Pranav221294/New_AFT_my_code/AFT_SENSOR/Design_DevelopmentDocs/EEPROM_data_on_2_Probe_Pic.png

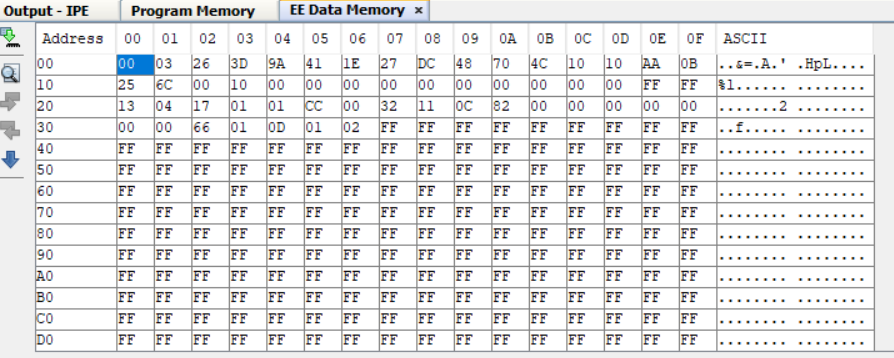
AFT_SENSOR/Design_DevelopmentDocs/EEPROM_data_on_2_Probe_Pic.png
