Pranav221294/New_AFT_my_code/AFT_SENSOR/Code/CodeWithBootLoader/Exe to generate bin/ReadMe.txt

after changing application .mot file to .bin file, rename the .bin file as Ultra24V.bin
then upload through app.
