Pranav221294/New_AFT_my_code/AFT_SENSOR/Requirements/AFT_Sensor_Technical_document_V0.0.pdf

# INDICATION INSTRUMENTS LIMITED

## Design Specification for AFT Sensor

This document is the property of Indication Instruments Limited Plot 19, Sector 6, Faridabad. This document or any information it contains may not be copied, reproduced, disclosed to others or used without the written permission from Veethree. This document must be returned upon request.

### P a g e 1 | 31

# Design Specification for

# AFT Sensor

## Approvals

## Customer: _________________________________________________

Name: | _____________ | ________________________________
Title: | _______ | __ | __________________________________
Date: | _________________ | __________

## Veethree: _________________________________________________

Name: | _____________ | ________________________________
Title: | _______ | __ | __________________________________

## Date:

# Facility: Indication Instruments Limited Plot No.19, Sector-6, Faridabad Haryana, India Rev# 0.0 Last update: May 31, 2022

### P a g e 2 | 31

# TABLE OF CONTENTS

### P a g e 3 | 31

# TABLES & FIGURES

No table of figures entries found.

### P a g e 4 | 31

# REVISION HISTORY

Rev | Date | Author | Reviewed By | Description
0.0 | 31st May 2022 | Ruchi Bhargava | Nikita/Anuj Garg | Initial version

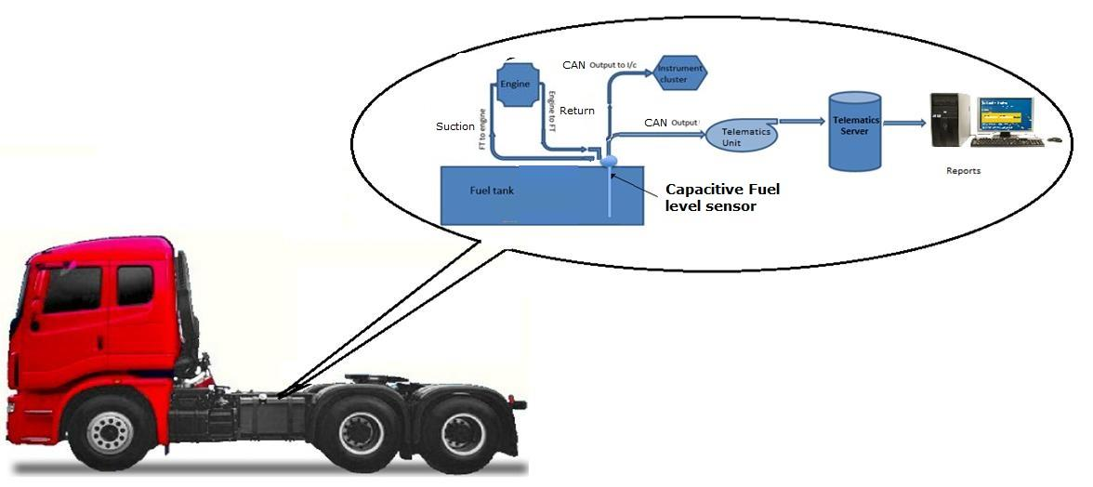
[picture p5: figure]

### P a g e 5 | 31

## 1.Introduction

## This document details the idea of Fuel Anti-Theft Sensor (AFT) or capacitive sensor. The proposed method of measurement of fuel level is based on the variation in the capacitance

based on the difference in dielectric properties between fuel and free air without any moving parts. The details of implementation are outside the scope of this document.

## 2. Acronyms, Abbreviations and Definitions

AFT | Anti Fuel Theft Sensor

## 3. References

Reference | Document

## Emails exchanged with TML

## 4. System Architecture

## MCU Platform : Renesas

## Memory :

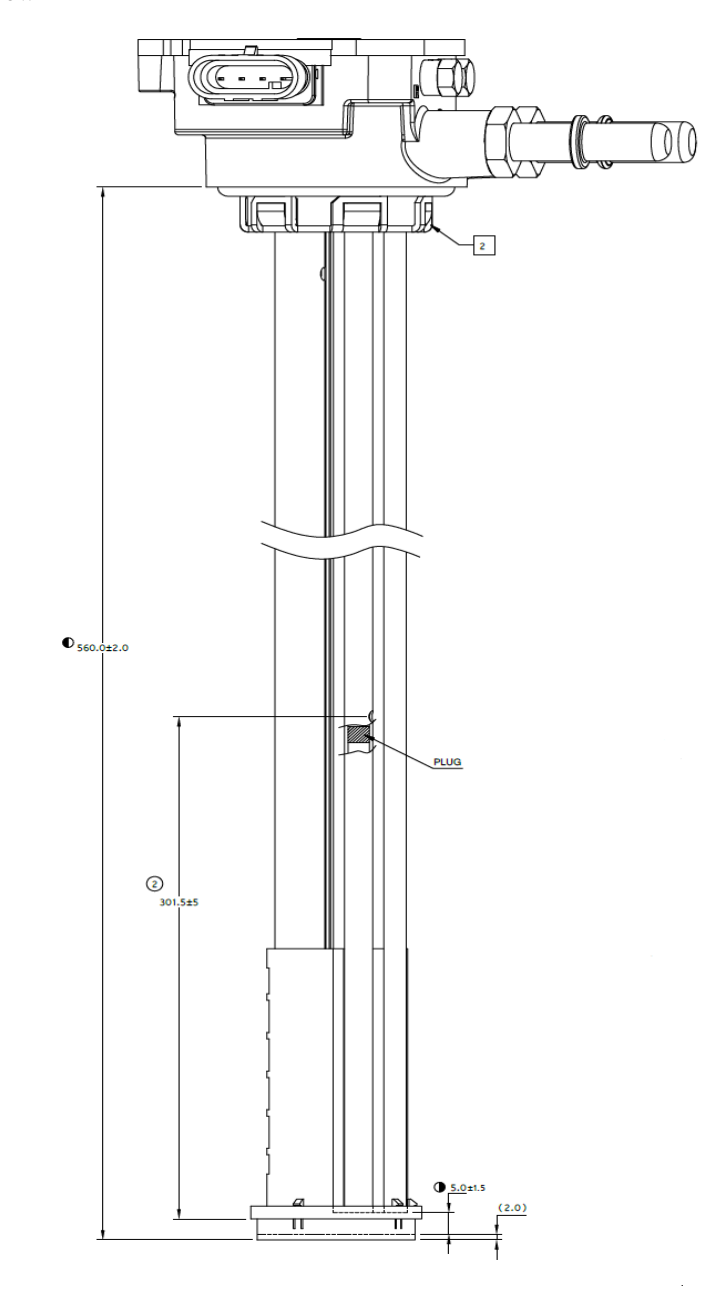
[picture p6: figure]

### P a g e 6 | 31

## 5. Fitment Requirement

Variant 1 : 365 Ltr.

## View From Arrow X

### P a g e 7 | 31

## View From Arrow Y

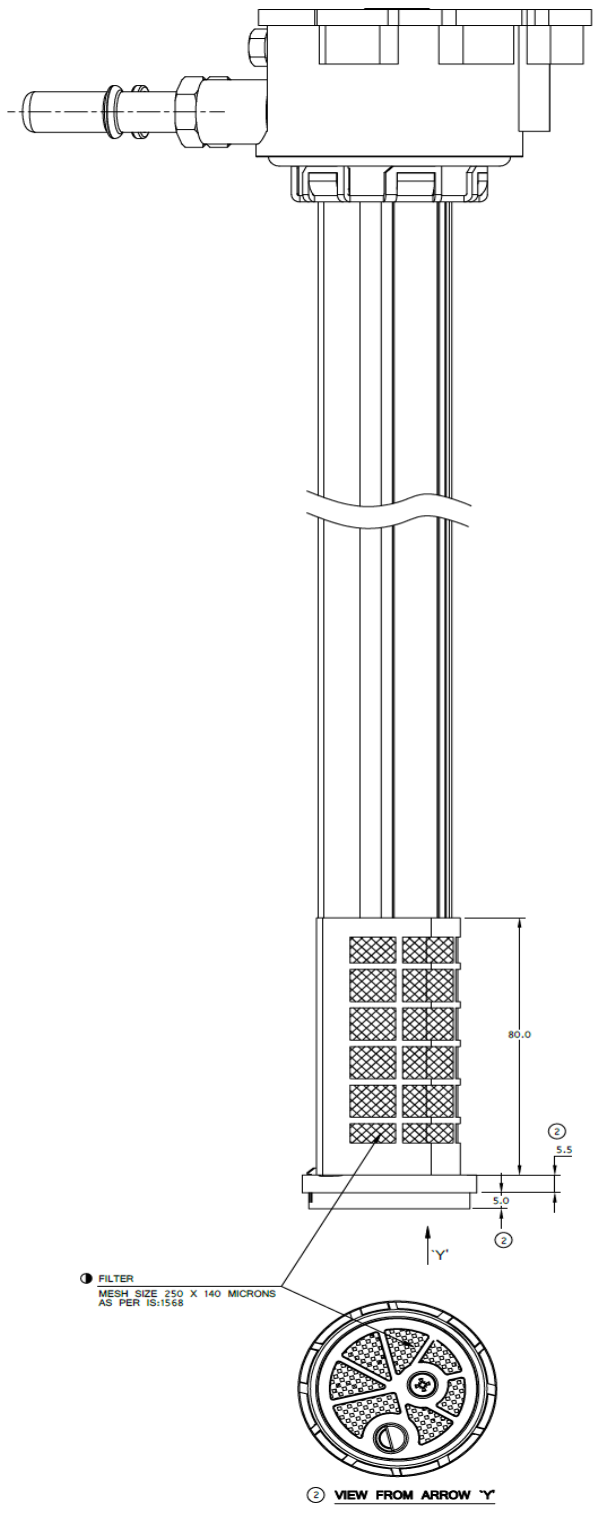
[picture p7: figure]

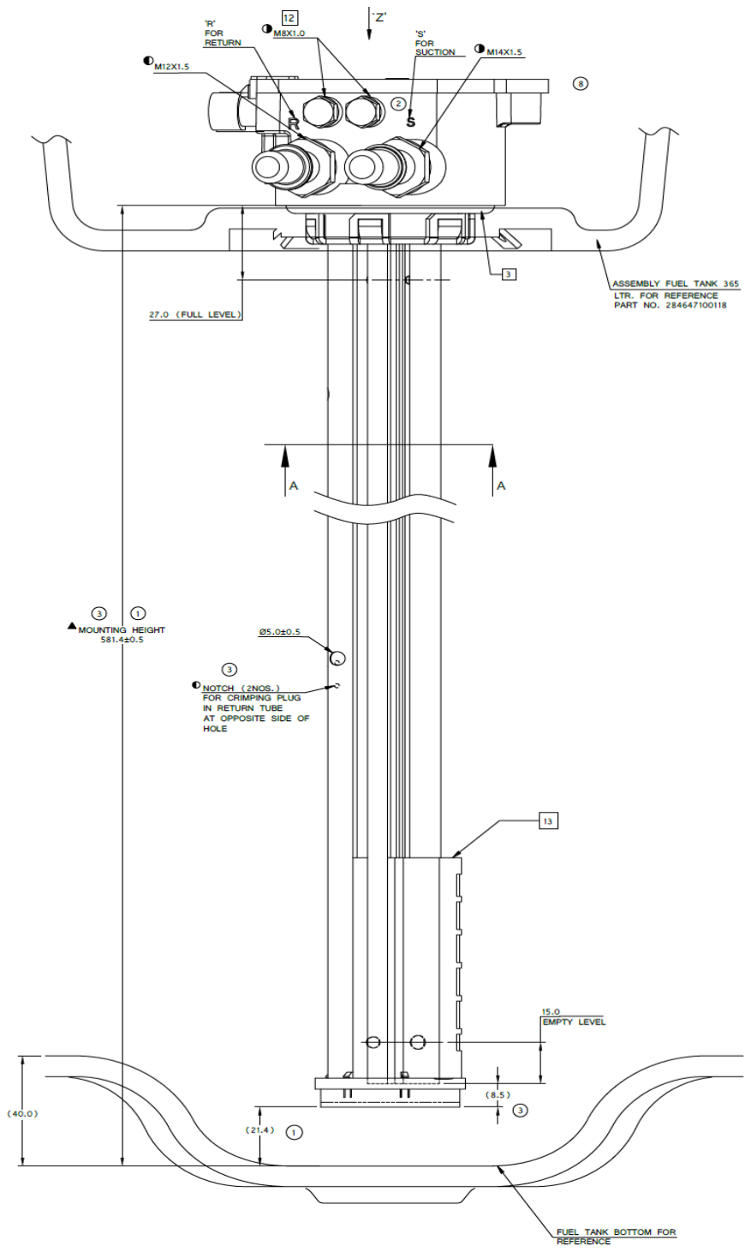
[picture p8: figure]

### P a g e 8 | 31

## View From Arrow Z

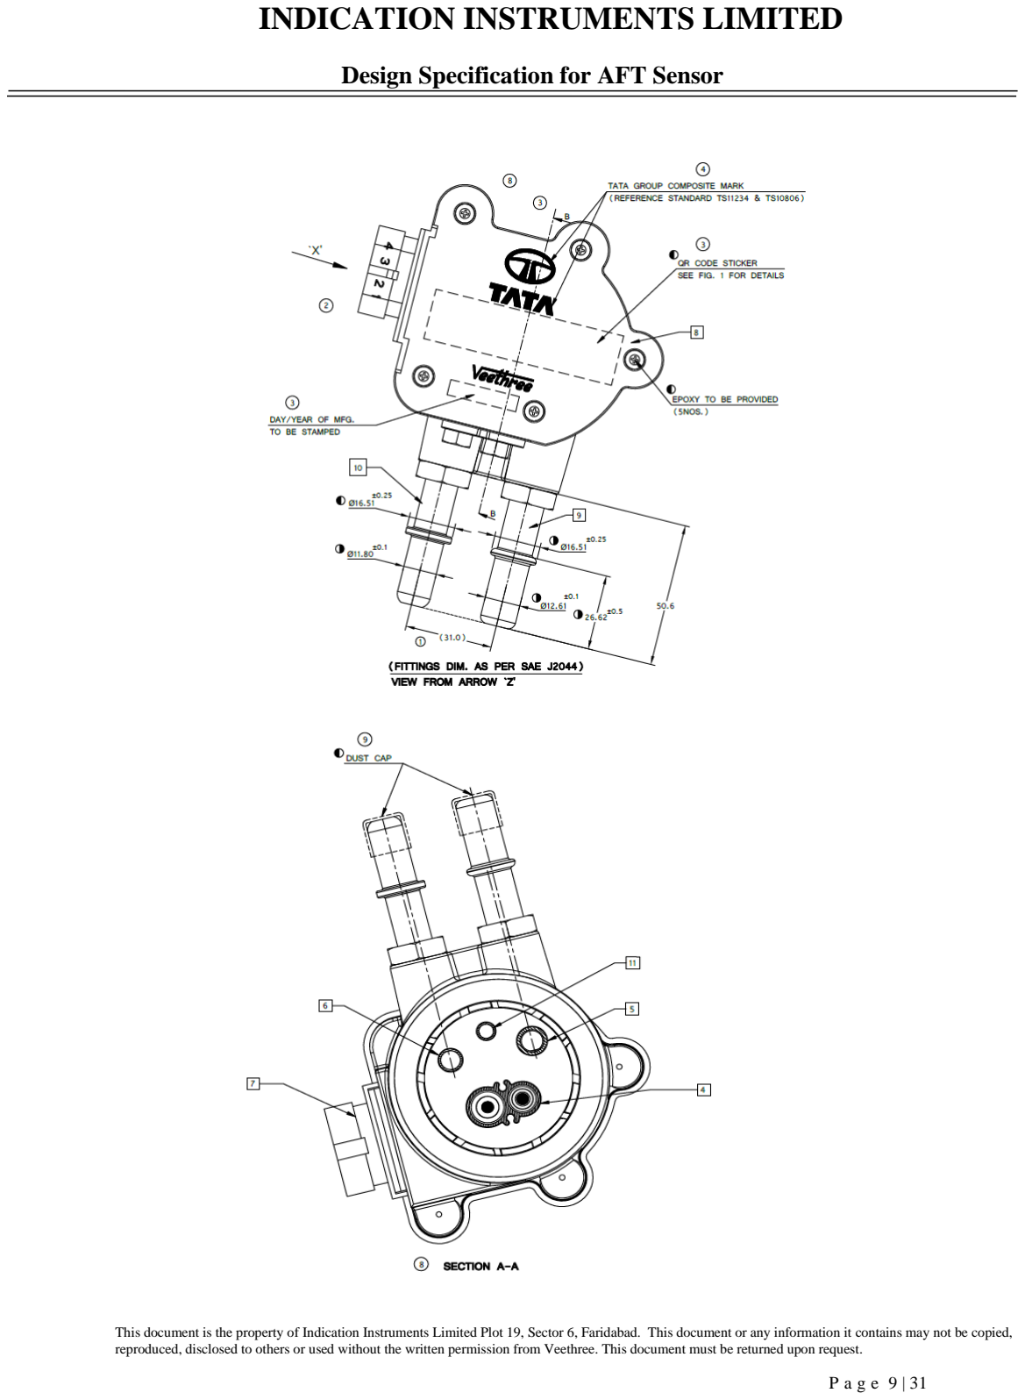
[picture p9: page 9]

### P a g e 9 | 31

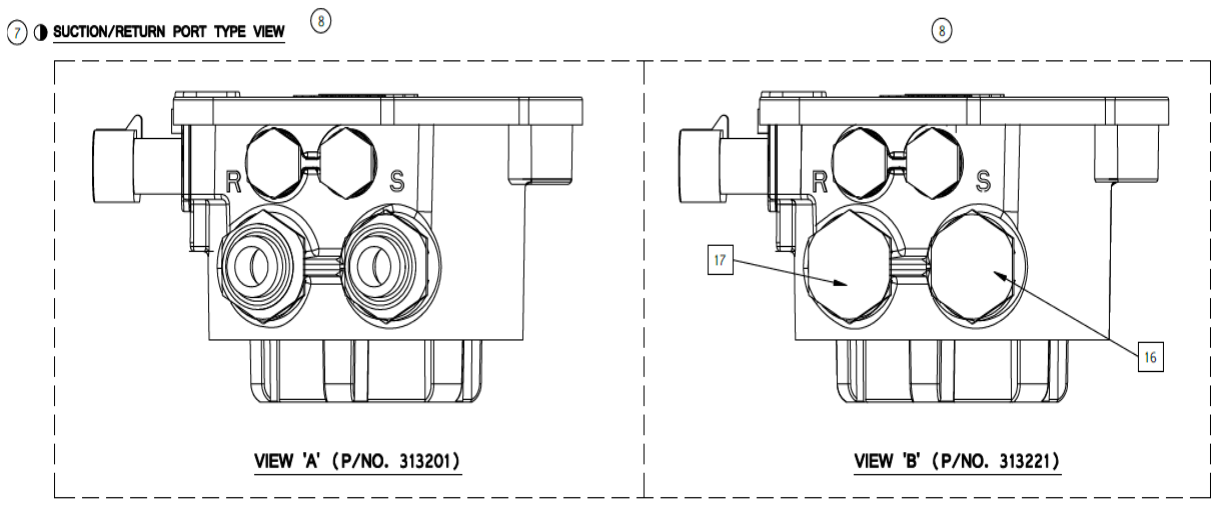
[picture p10: figure]

### P a g e 10 | 31

## Suction/Return Port Type View

Variant 2 : 300 Ltr. & 280 Ltr.

## View From Arrow X

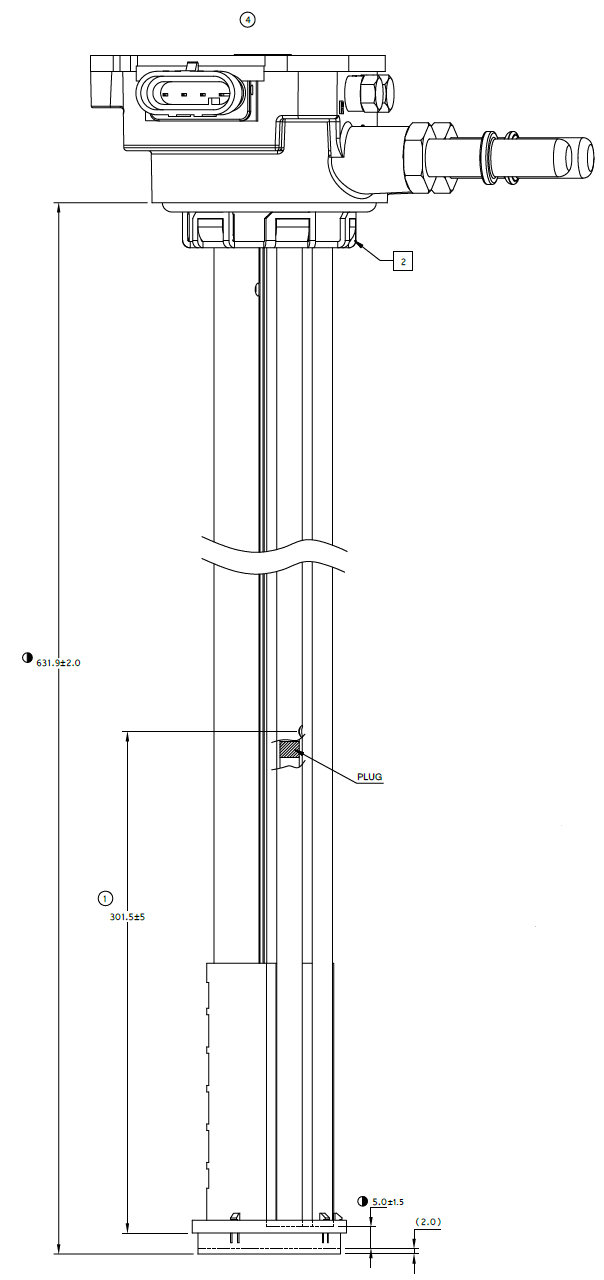
[picture p11: figure]

### P a g e 11 | 31

### P a g e 12 | 31

## View From Arrow Y

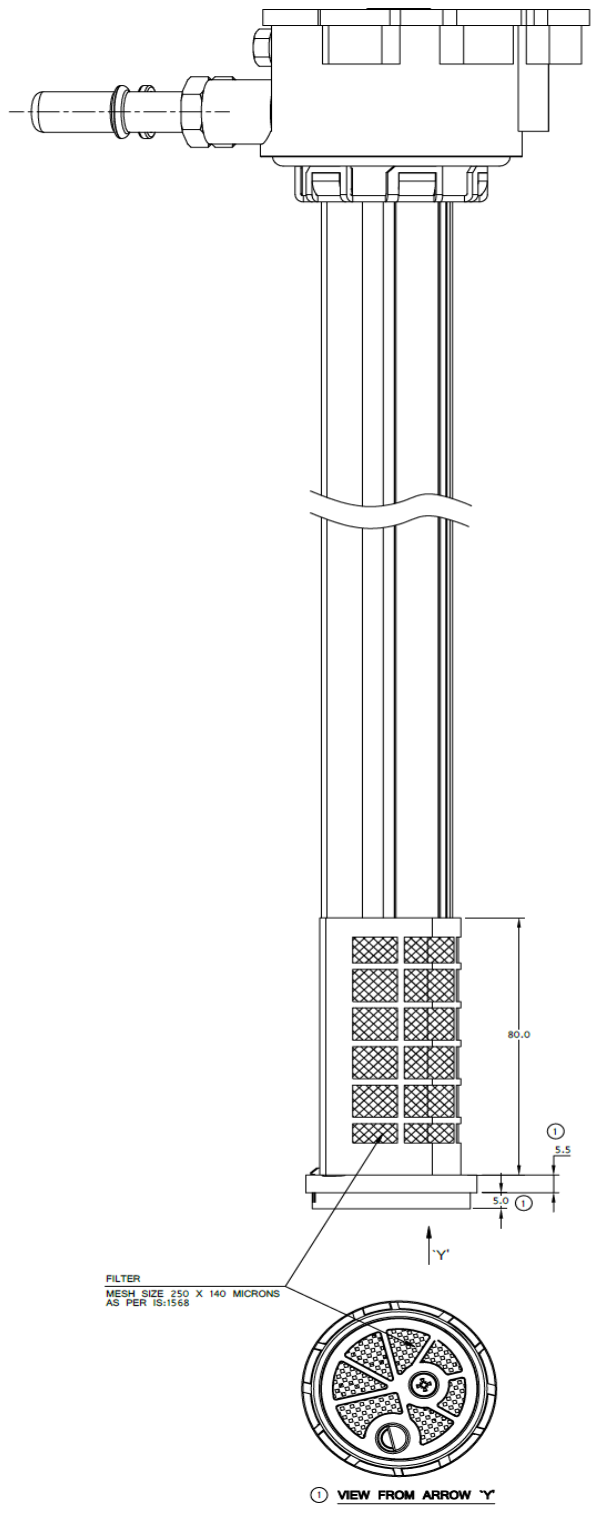
[picture p12: figure]

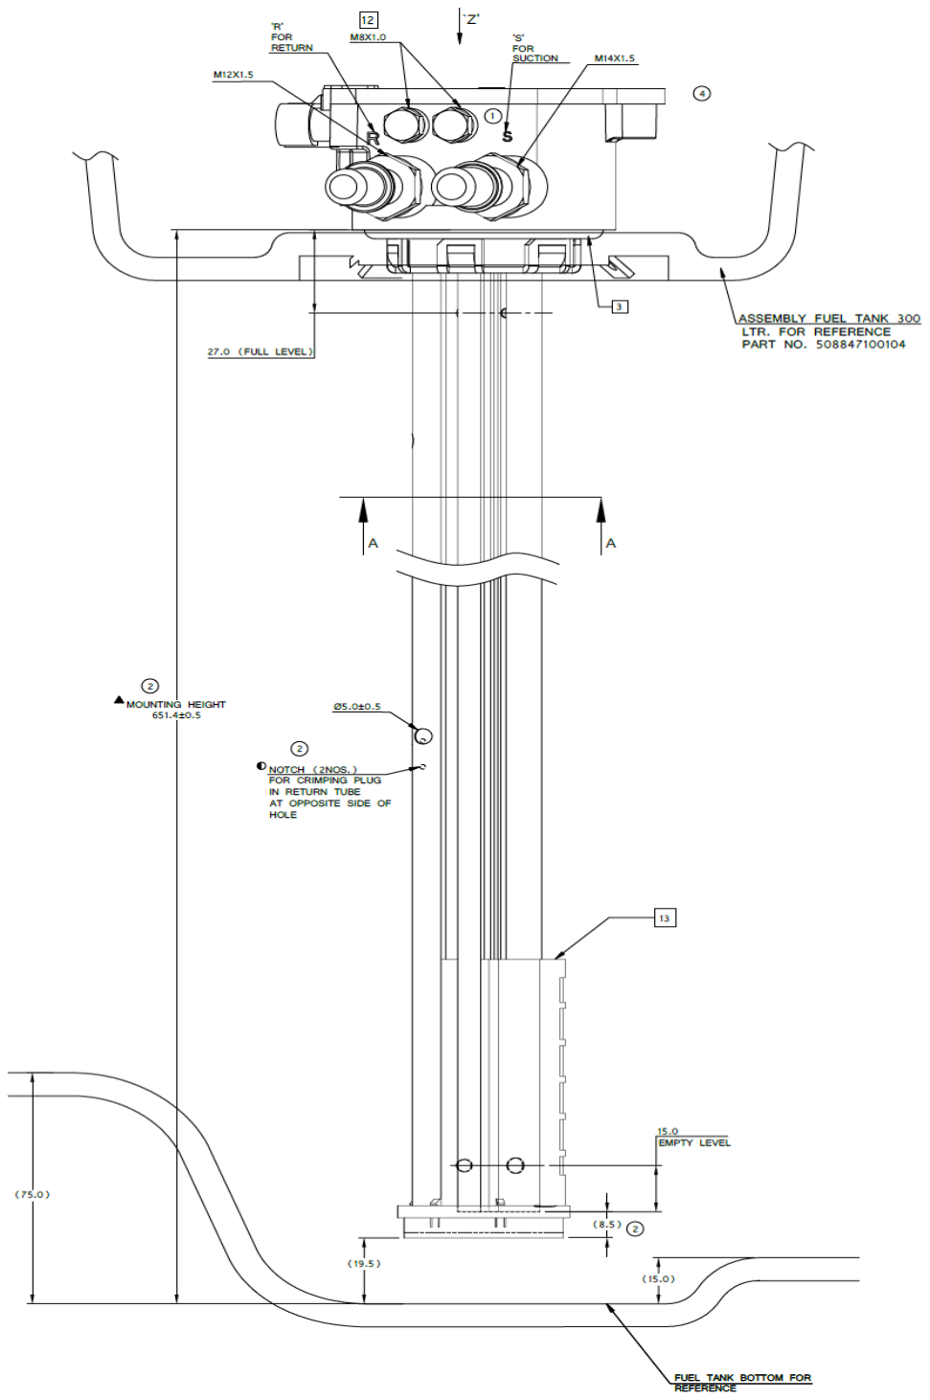
[picture p13: figure]

### P a g e 13 | 31

## View From Arrow Z

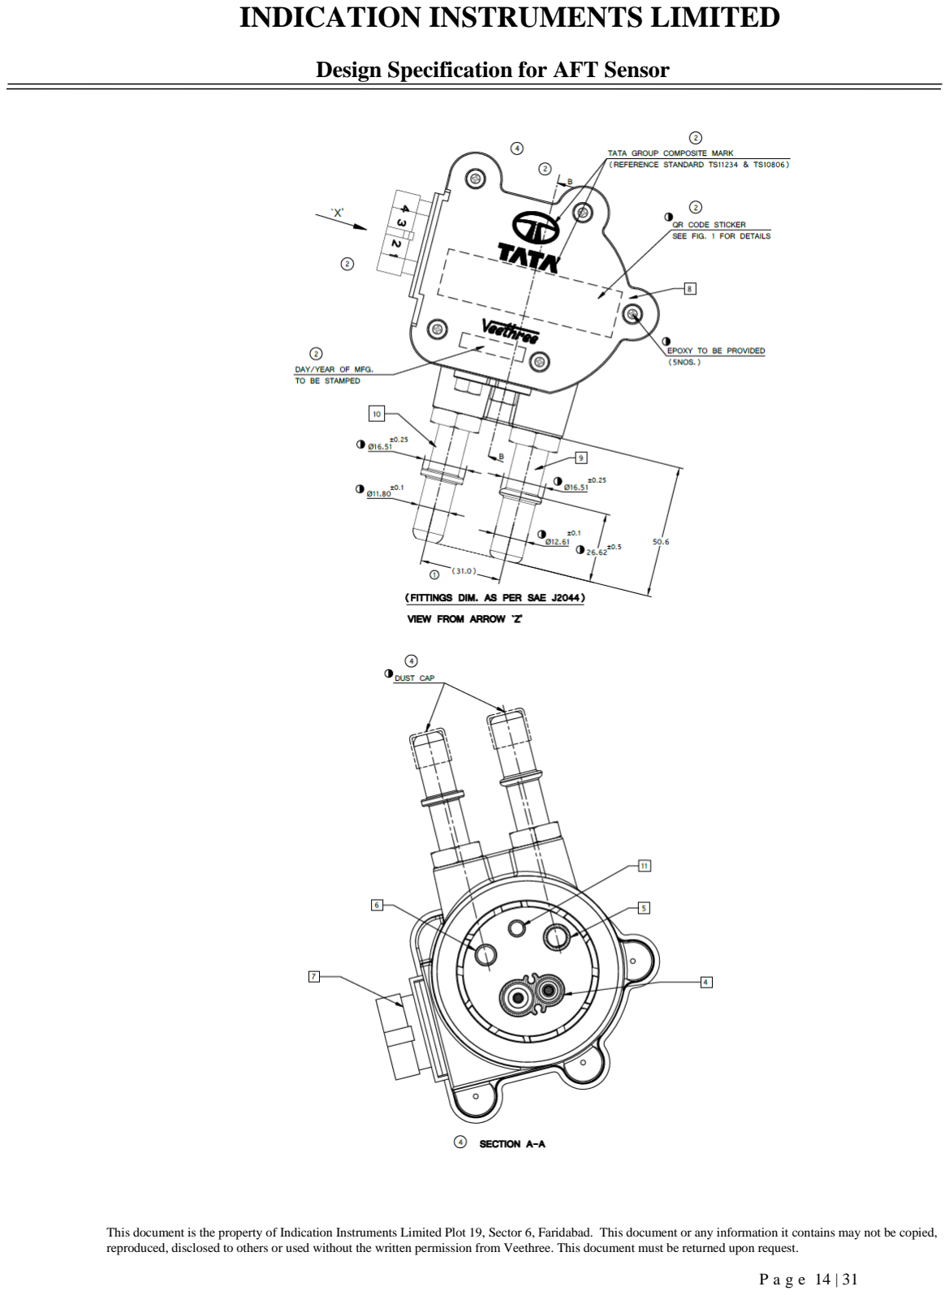
[picture p14: page 14]

### P a g e 14 | 31

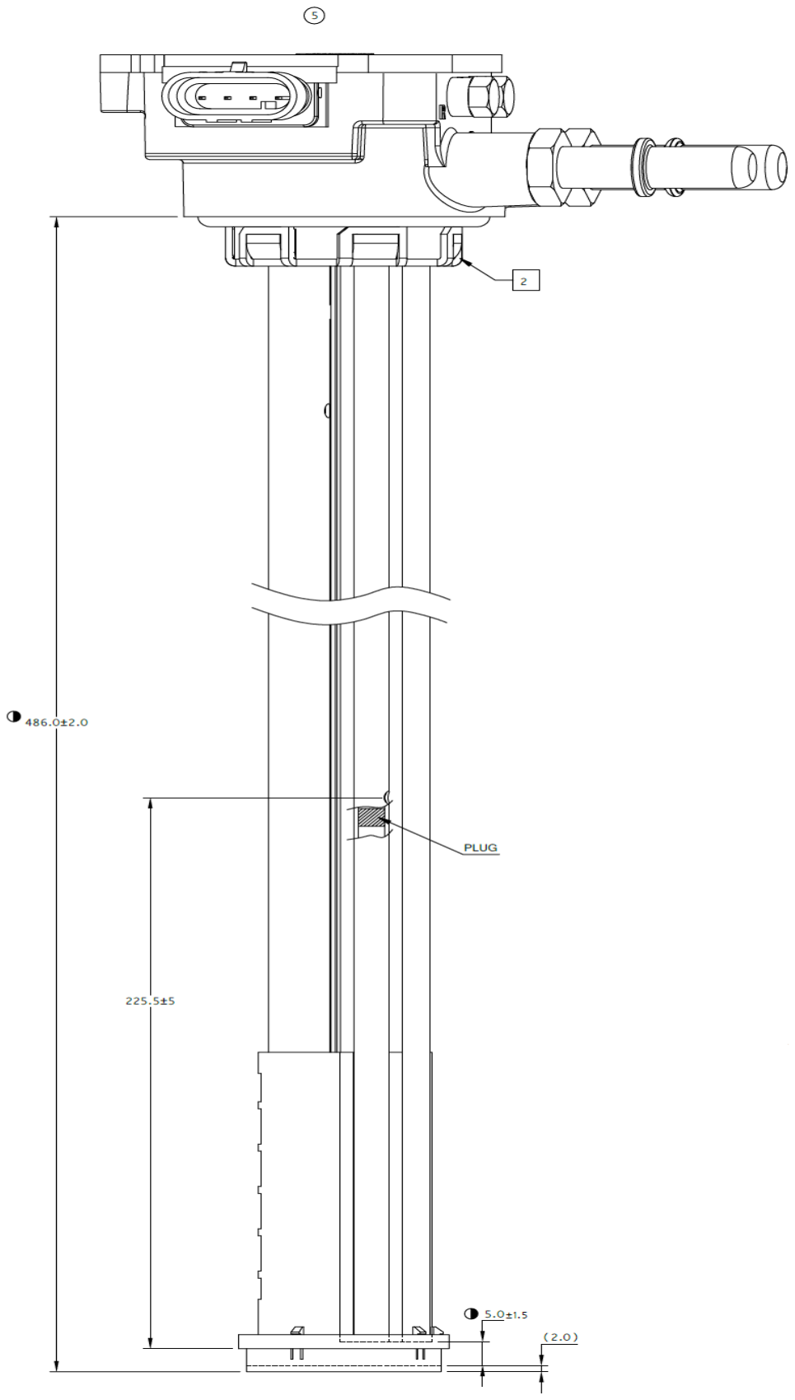
[picture p15: figure]

### P a g e 15 | 31

Variant 3 : 225 Ltr. & 350 Ltr.

## View From Arrow X

### P a g e 16 | 31

## View From Arrow Y

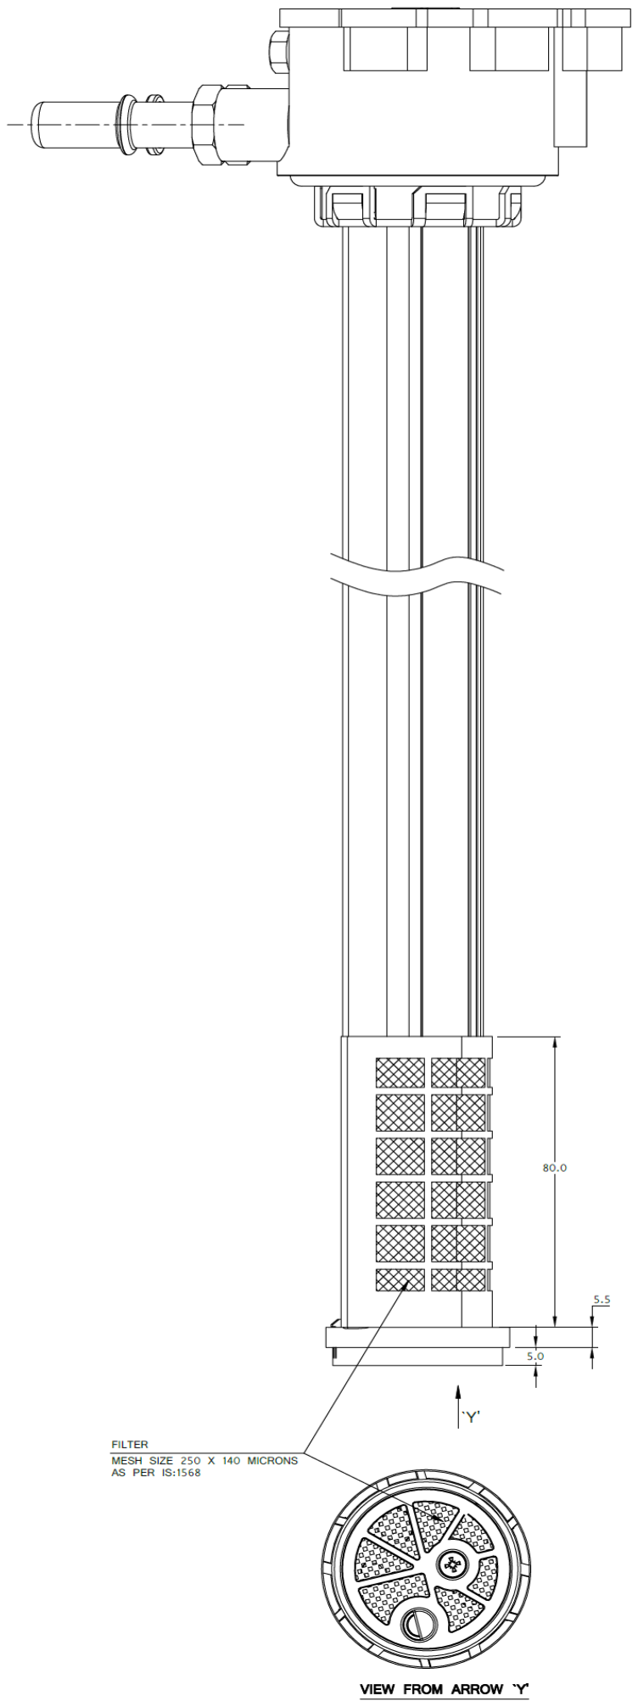
[picture p16: figure]

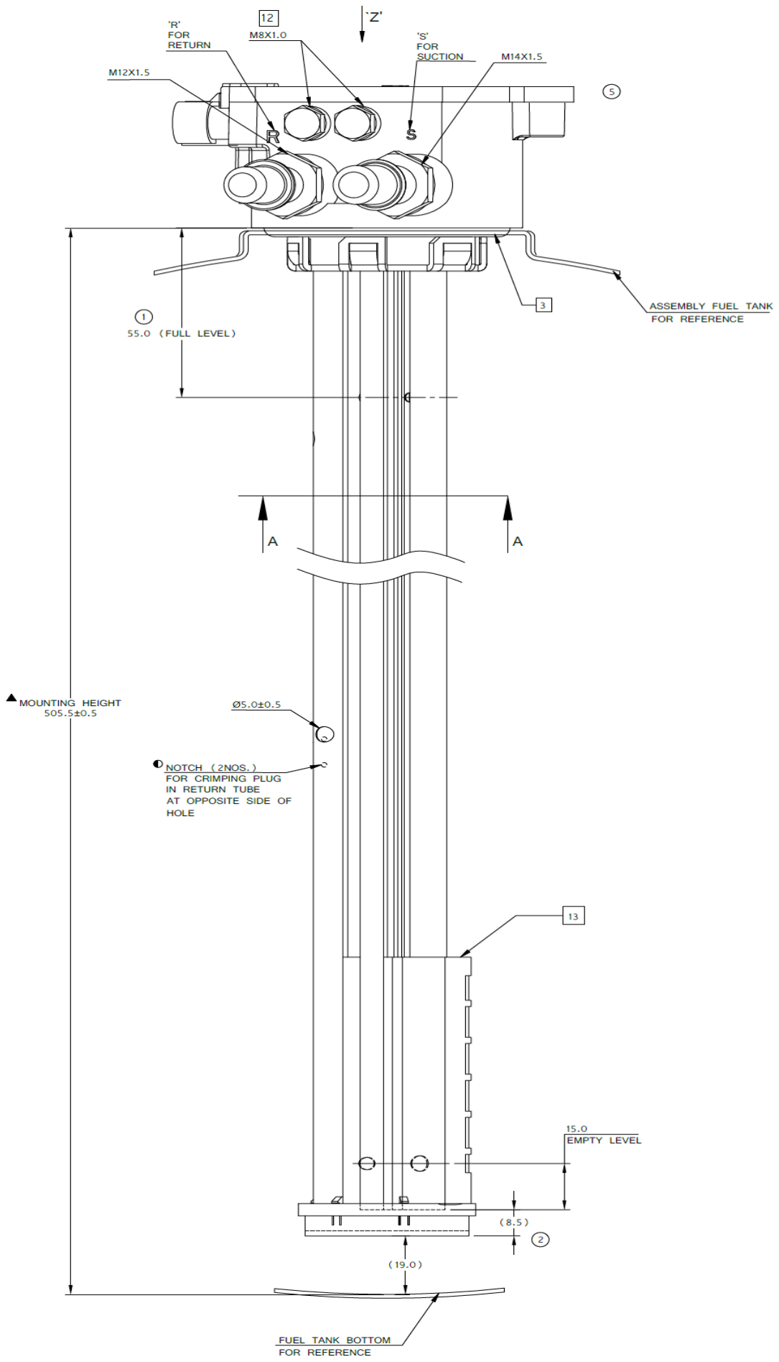
[picture p17: figure]

### P a g e 17 | 31

## View From Arrow Z

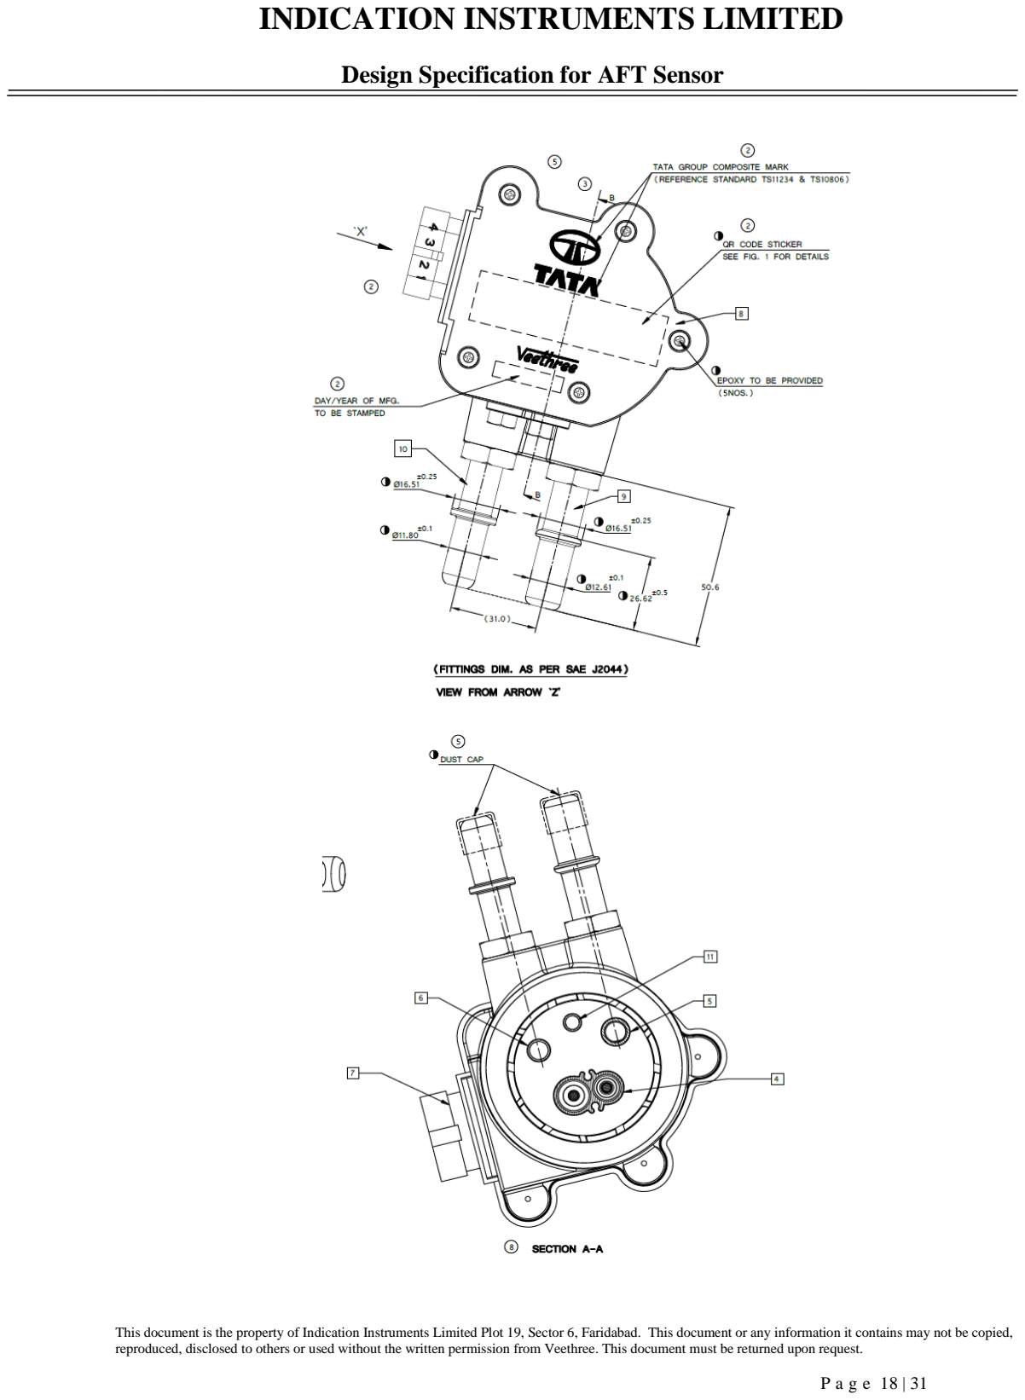
[picture p18: page 18]

### P a g e 18 | 31

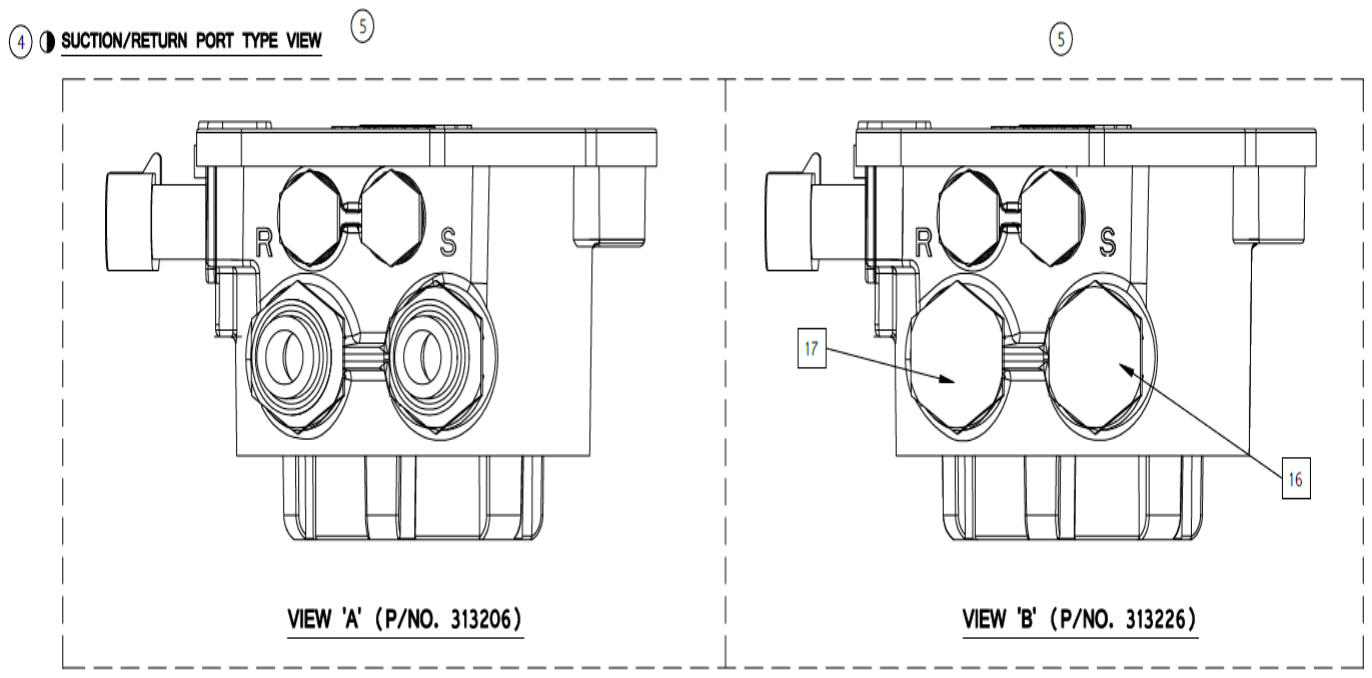
[picture p19: figure]

### P a g e 19 | 31

## Suction/Return Port Type View

Variant 4 : 192 Ltr.

## View From Arrow X

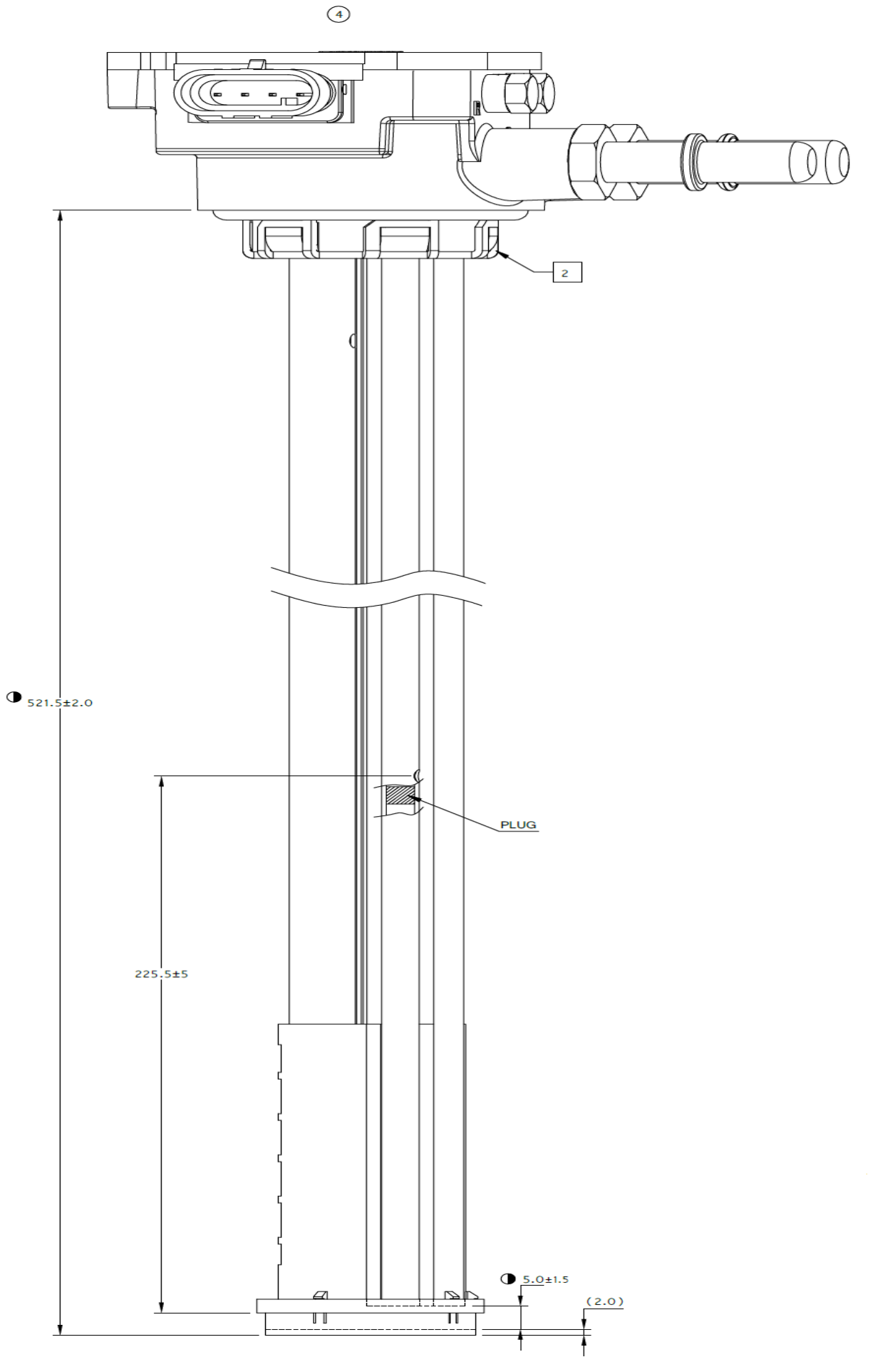
[picture p20: figure]

### P a g e 20 | 31

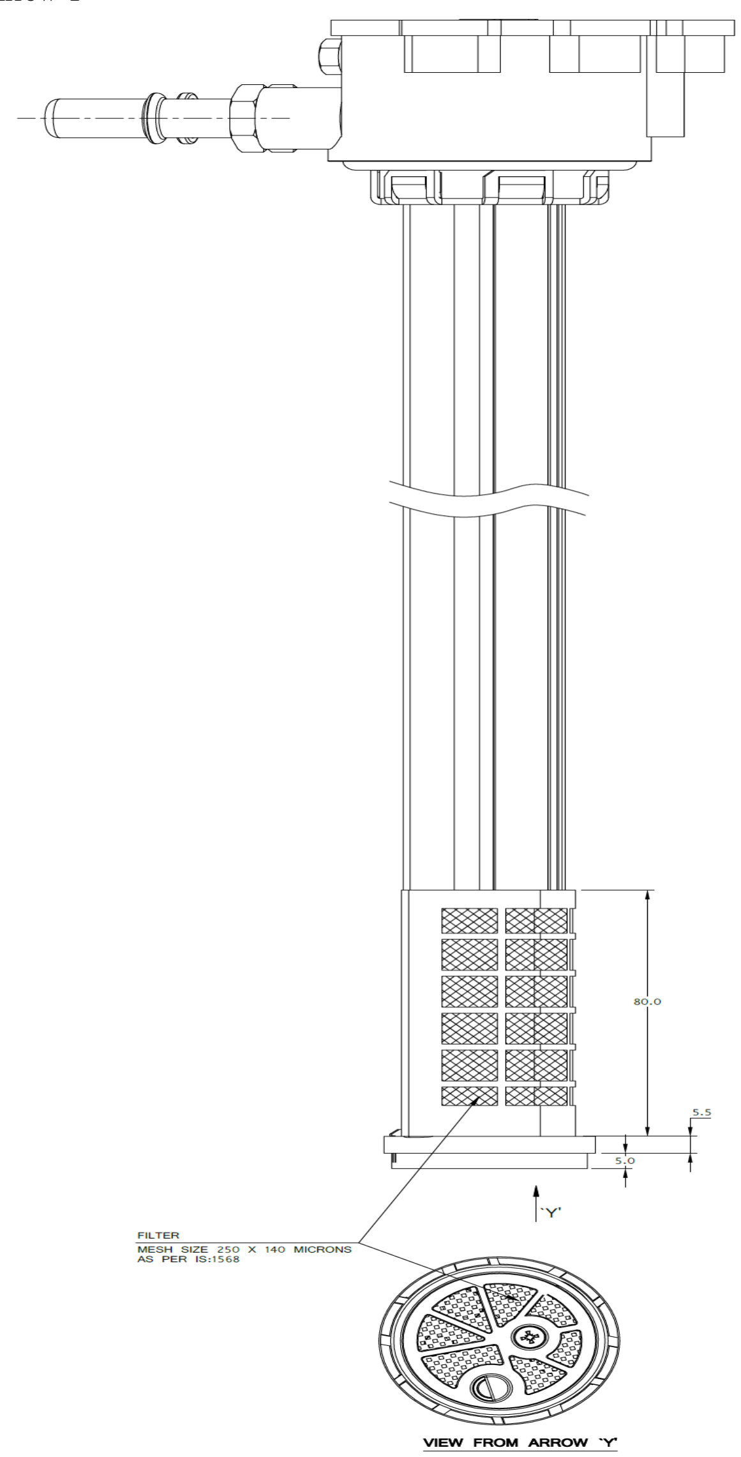
[picture p21: figure]

### P a g e 21 | 31

## View From Arrow Y

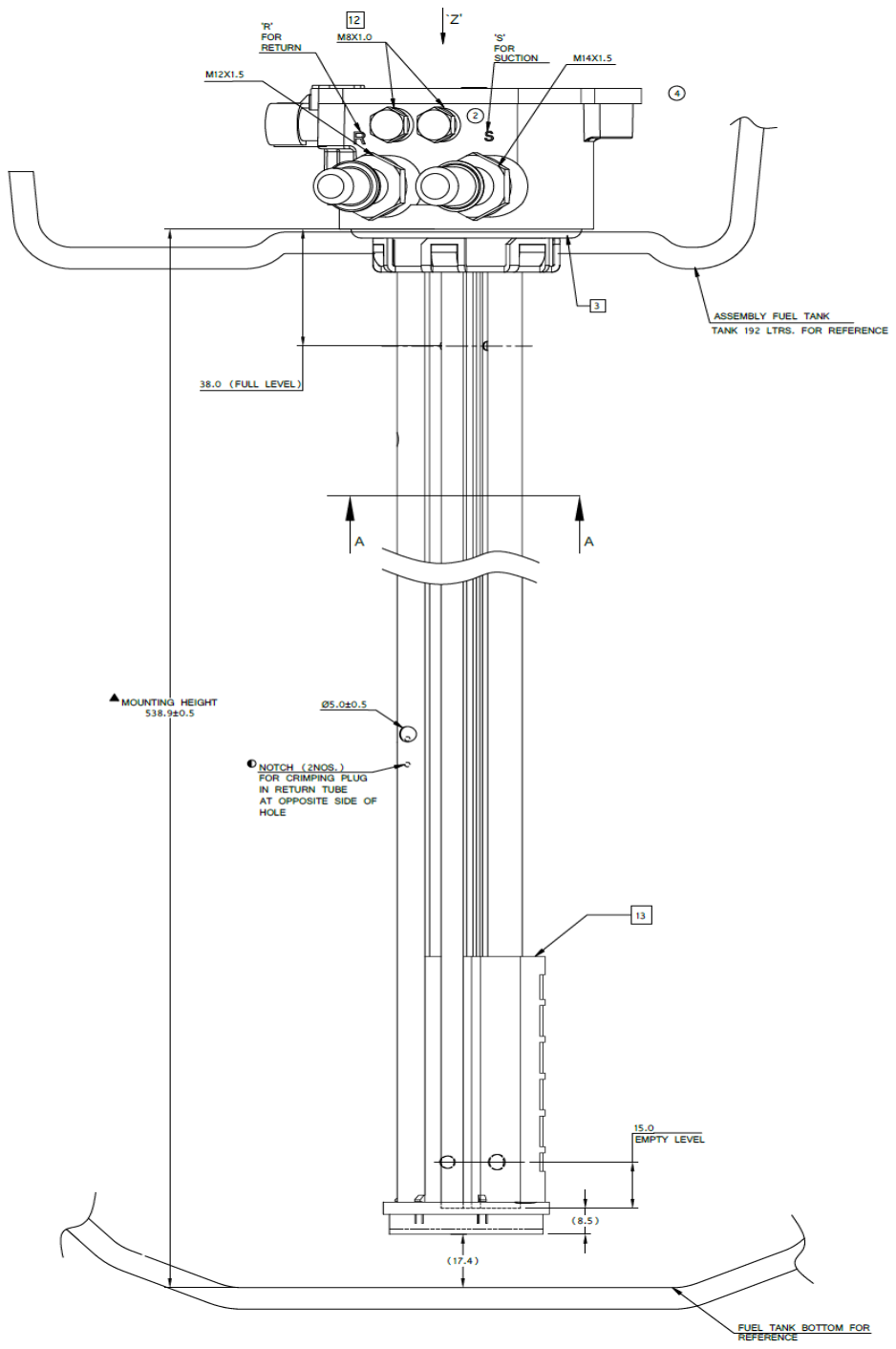
[picture p22: figure]

### P a g e 22 | 31

## View From Arrow Z

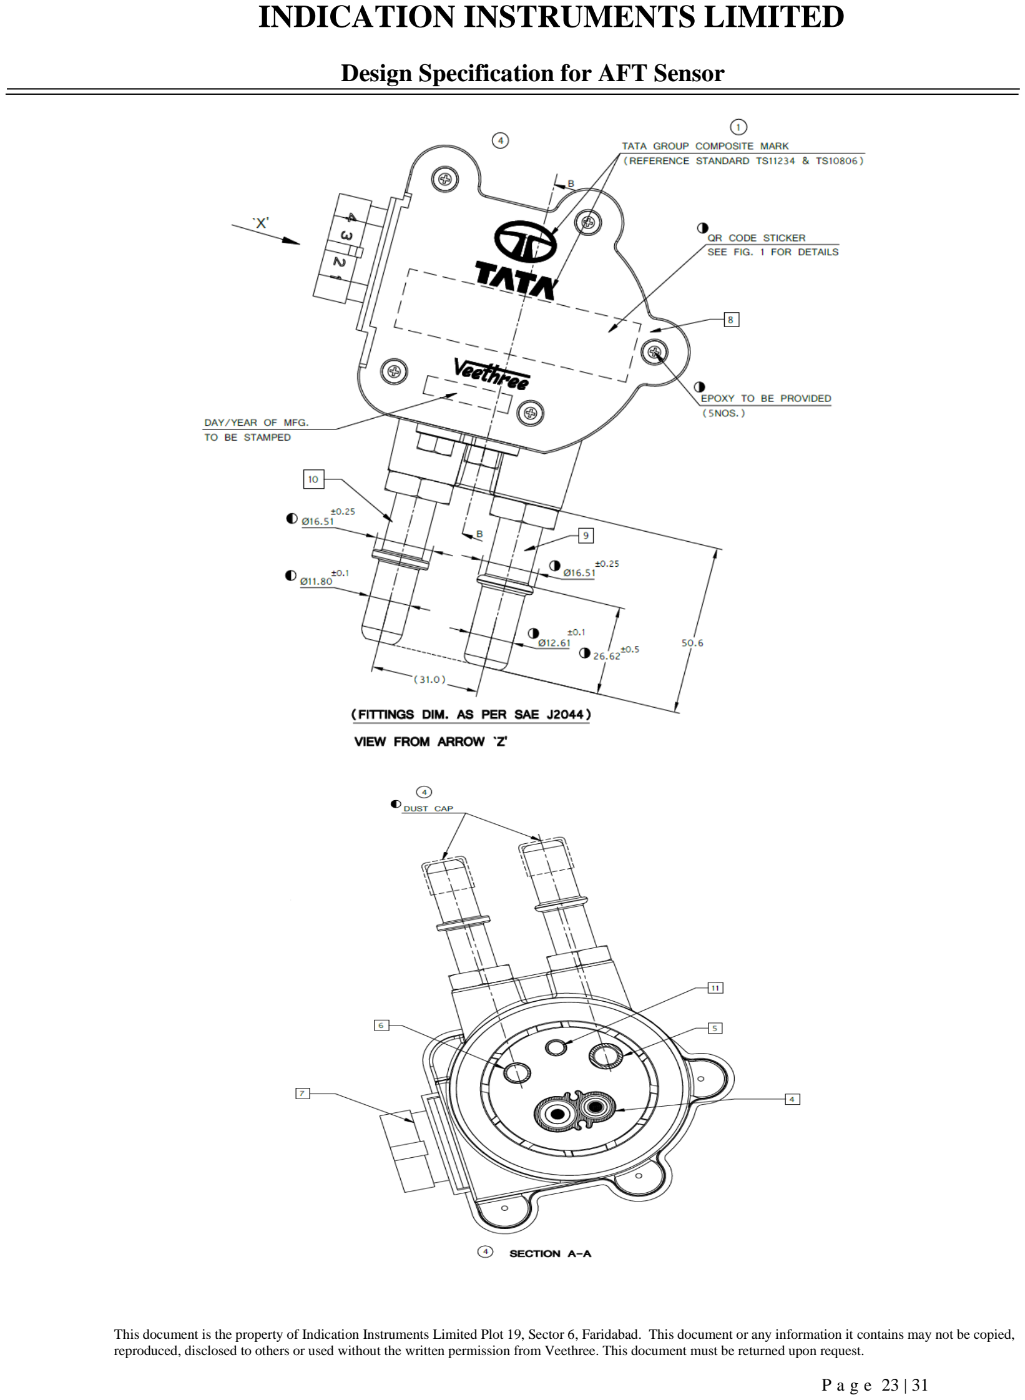
[picture p23: page 23]

### P a g e 23 | 31

## Suction/Return Port Type View

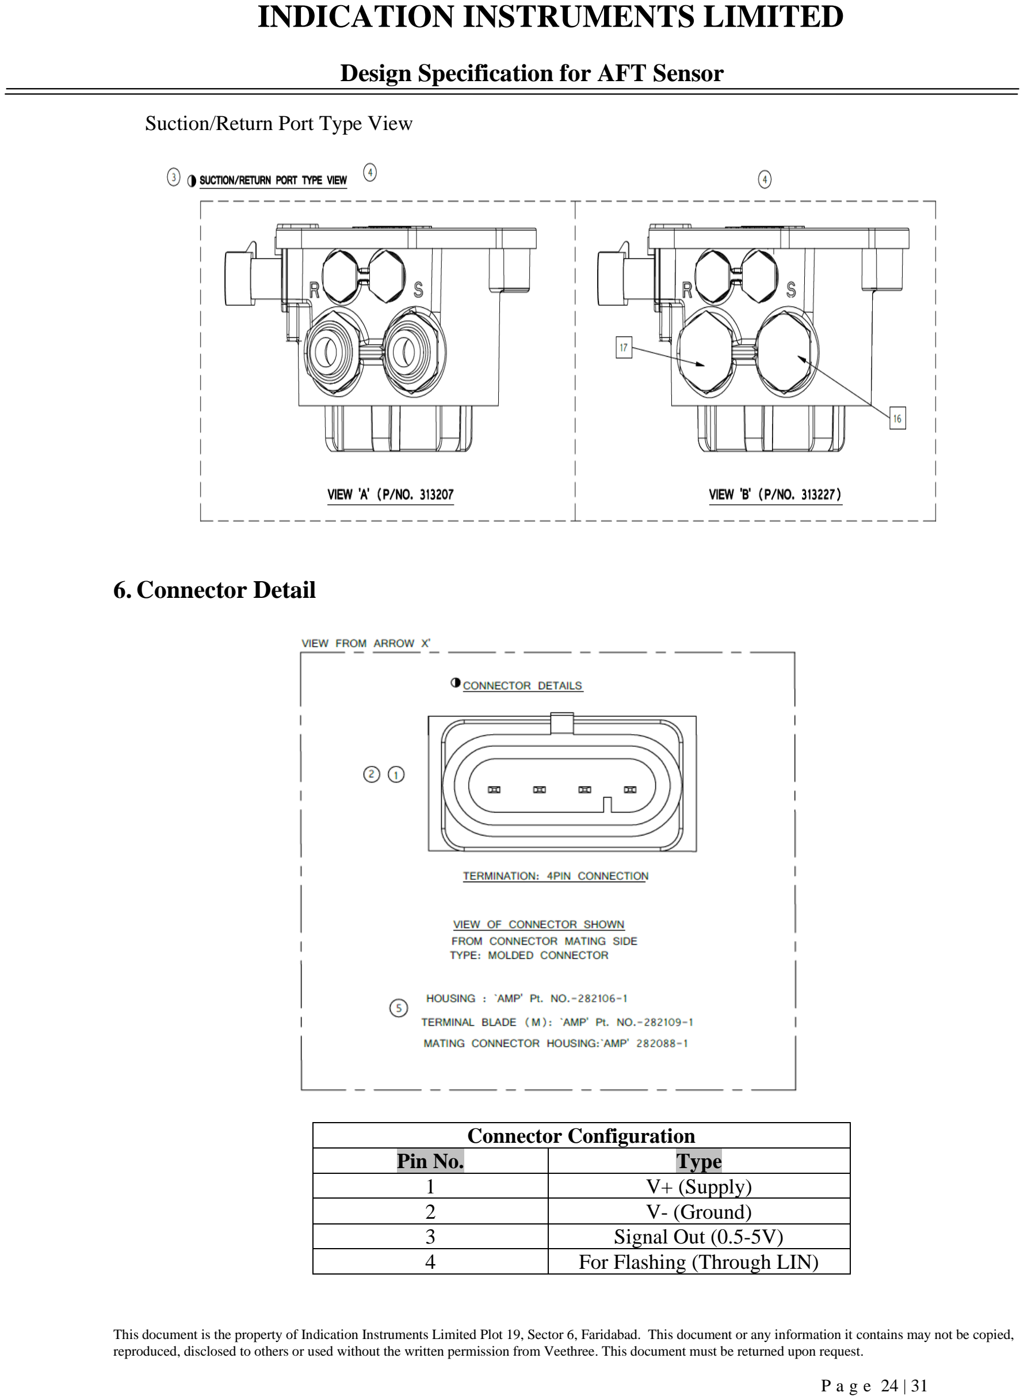
[picture p24: page 24]

### P a g e 24 | 31

## 6. Connector Detail

## Connector Configuration

Pin No. | Type
1 | V+ (Supply)
2 | V- (Ground)
3 | Signal Out (0.5-5V)
4 | For Flashing (Through LIN)

### P a g e 25 | 31

## 7. Operating Principle

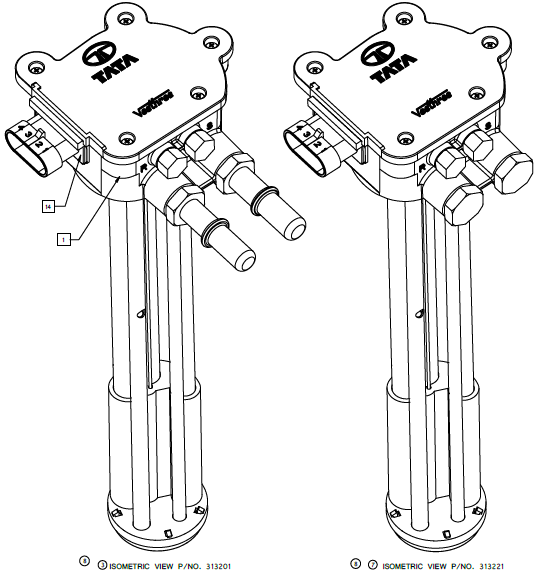
[picture p25: figure]

1.The software takes capacitance information from three channels;

## a. P0 refers to values taken from the electronics only. No capacitance probe

connected.

## b. P1 refers to values taken from the measuring probe P1. The capacitance probe with the 4mm outer diameter PTFE and 12mm inner diameter aluminium tube is

connected.

## c. P2 refers to values taken from the measuring probe P2. The capacitance probe with the 5mm outer diameter PTFE and 10mm inner diameter aluminium tube is

connected.

2.Set up probe output, output range and high/low alarm levels etc using GUI setup screen.

## 3.Calibrate probe in Diesel:

## a. Do not pre-wet probe before taking empty readings

## b. Power up at empty with calibration pad connected to ground (for 10 seconds)

## i. Value of P1_at_empty is recorded 16 bit

## ii. Value of P2_at_empty is recorded 16 bit

### P a g e 26 | 31

## iii. Value of P0_at_empty is recorded. P0 is the value obtained when both probes are deselected. 16 bit

c. Remove ground connection from calibration pad and insert in diesel up to full level.

## Reconnect calibration pad to ground (for another 10 seconds)

## i. Value of P1_at_full recorded 16 bit

## ii. Value of P2_at_full recorded 16 bit

## d. Calculate value of P1 raw span:

## raw_p1_span = P1_at_full – P1_at_empty 16 bit

## e. Calculate value of P2 raw span:

## raw_p2_span = P2_at_full – P2_at_empty 16 bit

## f. Calculate m. Constants 14.4 and 7.07 are derived from multi fluid testing:

## m = 14.4 – (7.07 x (raw_p1_span) / (raw_p2_span)) g. Calculate & record divisor at calibration. Constant 6.3 derived from multi fluid testing:

## div@cal = (m x (raw_p1_span) / (raw_p2_span)) – 6.3 h. Calculate value of probe span:

## p1_span = raw_p1_span / div@cal i. Probe now fully calibrated

4.Probe now inserted into application fluid. Calculate current level in probes as follows:

a. Temperature effects on Electronics.

## P0x = P0 - P0_at_empty If this is negative then set negative flag NEG = 1 and create complement P0x = (P0x XOR 1111111111111111) + 1

b. Temperature effects on Probe 1. Value of constant, 1.4, is based on empirical data.

## Value will be negative if negative flag set:

## P1_drift_factor = 1.4 x (P0 - P0_at_empty)

c. Temperature effects on Probe 2. Value of constant, 1.05, is based on empirical data.

## Value will be negative if negative flag set:

## P2_drift_factor = 1.05 x (P0 - P0_at_empty)

d. Current level in Probe 1.

## p1 = P1 - P1_drift_factor – P1_at_empty e. Current level in Probe 2

### P a g e 27 | 31

## p2 = P2 – P2_drift_factor – P2_at_empty f. Calculate live divisor

## div = m x (p1/p2) - 6.3 g. Average divisor is

## div_average = (divn + divn-1 + divn-2 …… + divn-15) / 16 h. Lower limitation on value of divisor is

## 0.97 x div@cal i. Every 15 minutes the average value of divisor is stored to EPROM. The EPROM has 1 x 10⁶ write cycles so assuming 24 hour operation the probe has a life of 28.5

years.

## div_average_store = div_average j. At low immersion levels the divisor calculation can be affected by turbulence and mechanical variations (probe eccentricity). To stop the calculation at low levels, a 20% diesel fill limitation is used

If p1 < 0.2 x raw_P1_span,

## then ignore div_average and use div_average_store

## k. At power up condition, before a new divisor can be calculated, stored divisor is used. In the case of switching off and refilling the tank with a different fluid, an error might be apparent for first 5-10 seconds after power up while recalculation

occurs.

## l. Calculate level of fluid

## Q1 = p1/ div_average /p1_span m. Level Q1 is turned into a PWM signal from 0 to 1024. At this point the lower

output offset and span are taken into account.

## PWM 0 = 0% +ve duty cycle (output from micro is 0V) PWM 1024 = 100% +ve duty cycle (output from micro is 5.1V)

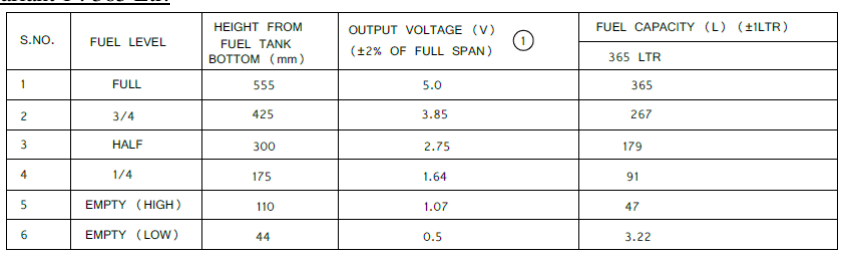
[picture p26: figure]
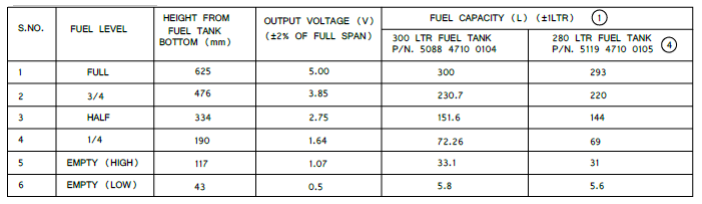
[picture p27: figure]
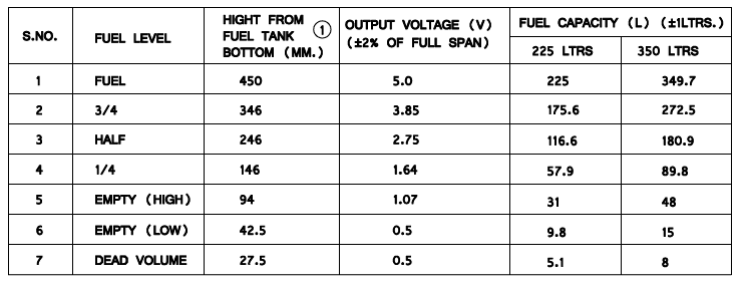
[picture p28: figure]

### P a g e 28 | 31

## 8. Variants and calibration

Variant 1 : 365 Ltr.

Variant 2 : 300 Ltr. & 280 Ltr.

Variant 3 : 225 Ltr. & 350 Ltr.

Variant 4 : 192 Ltr.

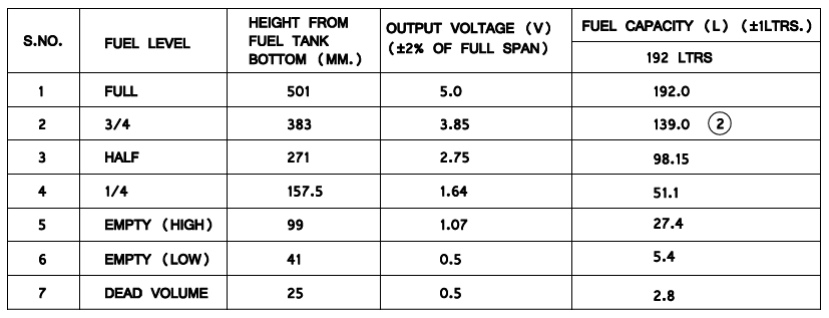
[picture p29: figure]

### P a g e 29 | 31

## 9. Mechanical Specifications

- Sensor head of fuel sensor are suited for mounting of fuel tank with Ø50.5 mm hole.

## (As per view ‘C’)

- Fitment of fuel sender – Bayonet type with ‘O’ ring, use proper tool for fitment of fuel

## sender in fuel tank

- Installation torque – Vertical force at least 400N. maintain the vertical press and rotate the gauge 30º clockwise.

## - Do not use more than 45Nm. There should be no leakage of fuel after the unit is tightened - Suction/return fitting/plug torque - 20±5Nm - Filter pull out force after assembly should not be less than 8.0 kg-f - Sealing of sensor head – IP69K

## 10.Electrical Specifications

## - Operating voltage – 9-32 VDC with 80V over voltage protection - Supply current – 15mA @12 VDC & 23mA @24 VDC - Output signal – 0.5 VDC (Empty) to 5 VDC (Full) - Resolution – 10mV - Accuracy - ±2.0% @20ºC (+68ºF) in diesel with dielectric constant value of 2.1 to 2.3

- Sleep current – 10mA Max.

## 11.Environmental Specifications

## - Operating temperature range : -40 to +85 Deg Celsius - Storage temperature range : -40 to +90 Deg Celsius

- All steel parts are to be zinc plated and trivalent yellow passivated (As per FeZn8 Cr III

## Y as per TS : 10812)

### P a g e 30 | 31

## 12. General Specification

## - Vehicle operating system voltage – 24V DC with negative ground - Fuel sender to be calibrated at all fuel indication level - The fuel sender is self-calibrating, which means its accuracy stays within ±10% even if used in different fuel, as long as dielectric constant of fuel is within 1.75 to 3.0

- The PCBA should have conformal coating.
- Guiding strips (2 nos) to be used in both the probes assembly.
- Dimensions without tolerance are for reference only.
- Loctite SI 5910 should be used for sensor head sealing.

## 13.Flashing Through Bootloader

## It supports the flashing of programming file using LIN driver. After flashing calibrate?

LIN details – ➢Single wire (+GND) ➢Supports baud rate upto 1-20 kbps, 6-bits identifier ➢Upto 40 mtr bus length ➢Variable data length – 2, 4, 8 bytes ➢Operating voltage – 12V ➢Uses time triggered scheduling with a guaranteed latency time ➢Supports sleep and wake up mode ➢Less harness than CAN, single wire of 5V ➢LIN master serves as a gateway on the CAN bus ➢Deterministic rather than event driven, no bus arbitration ➢Does not have hardware controller and has no hardware error diagnostics

## 14.Testing Requirements

S. No. | Test Description | Reference | Acceptance Criteria
1 | Visual Check | As per Drawing | As per Drawing
2 | Height Vs Voltage Check | Work Instruction no. 251 Issue 07 | Work Instruction no. 251 Issue 07
3 | Leakage Test | ” | ”
4 | Volume Vs Voltage Check (System Level Check) | ” | ”
5 | Tri Voltage Tri Temperature Functionality Check | ” | ”
6 | Insulation Resistance Check | ” | ”
7 | Dielectric Strength Test | ” | ”
8 | High And Low Storage Temperature Test | ” | ”

### P a g e 31 | 31

9 | Dry Heat Test | ” | ”
10 | Cold test | ” | ”
11 | Rapid Temperature Change Test | ” | ”
12 | Thermal Shock Test | ” | ”
13 | Water Spray Test | ” | ”
14 | Salt Spray Test | ” | ”
15 | Resistance To Fluid | ” | ”
16 | Pressure Cycle and Vacuum Test | ” | ”
17 | Connector Engage and Disengage Test | Work Instruction no. 260 | Work Instruction no. 260
18 | Radiated Immunity | Work Instruction no. 257 Issue 07 | Work Instruction no. 257 Issue 07
19 | Radiated Emission | ” | ”
20 | Bulk Current Injection | ” | ”
21 | Conducted Transient Immunity along signal lines (3a and 3b) | ” | ”
22 | Conducted Transient Immunity along signal lines Pulse 1, Pulse 2, Pulse 3, Pulse 4 and Pulse 5a | ” | ”
23 | Electrostatic Discharge Test (Unpowered) | ” | ”
24 | Electrostatic Discharge Test (Powered) | ” | ”
25 | Conducted Emission Along Supply and Signal Lines | ” | ”
26 | Random Vibration Test | Work Instruction no. 251 Issue 07 | Work Instruction no. 251 Issue 07
27 | Slosh Test | ” | ”
28 | Contamination Test (MOEST) | ” | ”
29 | Drop Test with packaging | ” | ”
30 | Hot Plugging Test | Work Instruction no. 257 | Work Instruction no. 257
31 | Vehicle Level Fitment and Functionality Check | Work Instruction no. 251 Issue 07 | Work Instruction no. 251 Issue 07
32 | Tear Down Analysis | ” | ”
33 | AIS004 Part3 Certification | As per AIS004 | As per AIS004

## 15.Future Development

- We can provide voice feedback system.

## - We can add vibration sensor to the vehicle. In case when vehicle is locked and somebody is try to open the vehicle lock then vibration will be produced and vibration

sensor can sense this vibrations and turn on the buzzer.
- It can be used for indication of BIO Fuels, to indicate the KMPL in vehicles, to monitor

## the average fuel consumption in vehicles, can be used in vehicles with different sizes

and shapes of tank.
