Pranav221294/New_AFT_my_code/AFT_SENSOR/Design_DevelopmentDocs/AFT Div data calculation trials sheet .xlsx

Sheet: with IIL calculations
Date | 2020-04-18
Purpose |  | To demonstrate interchanging probes can lead to change in full level output voltage from 4.2V to 5.1V by using diagnostics data read from faulty fuel level sensor.
Data description |  | Calibration data calculated from O1 & O2 sensors is fed into Table 1. Live raw data for the full level is fed into Table 2. Table 3, 4, 5, 6 show calculations done in software to derive level. Note Output voltage in Table 4 & Table 6 for output voltage at full level.
 |  | Calibration data
 |  |  |  | Table 1: Stored raw data in memory
 |  |  |  | P0E | P1E | P2E | P1F | P2F | div@cal | m
 |  |  |  | 9576 | 14727 | 15764 | 17355 | 18199 | 1.006192145 | 6.769626283
 |  |  | O1 | 9930 | 16685 | 15561 | 19333 | 18499
 |  |  | O2 | 9861 | 16604 | 15493 | 19289 | 18467
 |  |  |  |  |  |  |  |  |  | Change in ratios of numerator and denominator in the level equation, at full level
 | Run time diagnostics data |  |  |  |  | Table 2 : Live Raw values |  |  |  | Old software
 |  |  |  |  |  | Raw P0 | Raw P1 | Raw P2 |  | (Raw P1-P1E) / (P1F-P1E) | Div. used / div@cal
 |  |  |  |  |  | 9603 | 16545 | 17709 |  | 0.69 | 15.86
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
