Pranav221294/New_AFT_my_code/AFT_SENSOR/Design_DevelopmentDocs/Formula Used.xlsx

Sheet: Sheet1
 | Live Value of AFT |  |  |  |  |  | Calibration Values at AFT
28
 | Average Divisor Over 20 | 28 | AVDIVL_OVER20 | F2 | A2F2 | 41714 | P1 at Calibration | 3A | P1EMPTYL | 0xC7 | C7 | 39C7 | 14791
 |  | 29 | AVDIVH_OVER20 | A2 |  |  |  | 3B | P1EMPTYH | 0x39 | 39
 | Final Divisor | 02C | DIVUSEDL | F2 | A2F2 | 41714 | P2 at Calibration | 50 | P2EMPTYL | 0xA1 | A1 | 3AA1 | 15009
 |  | 02D | DIVUSEDH | A2 |  |  |  | 51 | P2EMPTYH | 0x3A | 3A
 | Live P1 | 32 | TMR1HP1 | 29 | 5E29 | 24105 | P0 at Calibration | 63 | P0EMPTYL | 0x1D | 1D | 261D | 9757
 |  | 31 | TMR1UP1 | 5E |  |  |  | 64 | P0EMPTYH | 0x26 | 26
 | Live P2 | 35 | TMR1HP2 | F9 | 4CF9 | 19705 | Constant 1.4 | 65 | P1DFL | 0x66 | 66 | 0166 | 358
 |  | 34 | TMR1UP2 | 4C |  |  |  | 66 | P1DFH | 0x01 | 01
 | Live P0 | 38 | TMR1HP0 | 1E | 261E | 9758 | Constant 1.05 | 67 | P2DFL | 0x0D | 0D | 010D | 269
 |  | 37 | TMR1UP0 | 26 |  |  |  | 68 | P2DFH | 0x01 | 01
 | Current level In Probe 1 | 56 | CALCP1L | 61 | 2461 | 9313 | m at Calibration | 6A | M12L | 0xEA | EA | 03EA | 1002
 |  | 55 | CALCP1H | 24 |  |  |  | 6B | M12H | 0x03 | 03
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
