Pranav221294/New_AFT_my_code/AFT_SENSOR/Design_DevelopmentDocs/AFT_Observations/NewPCB_PWM/PWM_data.xlsx

Duty Cycle | TDR25 value (at 20KHz) | OutPut Voltage(V) Vin = 28.5v | OutPut Voltage(V) Vin = 9v
0.00% | 0 | 0.018 | 0.011
5.00% | 40 | 0.509 | 0.507
10.00% | 80 | 1.015 | 1.013
15.00% | 120 | 1.522 | 1.519
20.00% | 160 | 2.028 | 2.025
25.00% | 200 | 2.535 | 2.531
30.00% | 240 | 3.04 | 3.037
35.00% | 280 | 3.548 | 3.543
40.00% | 320 | 4.055 | 4.05
45.00% | 360 | 4.562 | 4.556
50.00% | 400 | 5.069 | 4.711
55.00% | 440 | 5.576 | 4.71
60.00% | 480 | 6.083 | 4.71
65.00% | 520 | 6.591 | 4.71
70.00% | 560 | 7.1 | 4.71
75.00% | 600 | 7.6 | 4.71
80.00% | 640 | 8.11 | 4.71
85.00% | 680 | 8.62 | 4.71
90.00% | 720 | 9.12 | 4.71
95.00% | 760 | 9.26 | 4.71
100.00% | 800 | 9.26 | 4.71
