Pranav221294/New_AFT_my_code/AFT_SENSOR/Design_DevelopmentDocs/AFT_Observations/SelfComp/17_01_2023/selfcompensation.xlsx

Sheet: Water
Self Compensation of AFT (365 ltrs) |  |  |  |  | Dielectric Constant ( Water ) | 105
Existing AFT
S.no | level (Spec in Volt) | Diesel | Water | Diff (Milli Volt)
1 | Full (4.9V-5.1) | 4.97 | 4.89 | 80.0
2 | 3/4th(3.75-3.95) | 3.88 | 3.78 | 100.0
3 | Half(2.65-2.85) | 2.72 | 2.74 | -20.0
4 | 1/4th(1.54-1.74) | 1.64 | 1.66 | -20.0
5 | Empty High(0.97-1.17) | 1.07 | 1.07 | 0.0
6 | Empty Low(0.40-0.60) | 0.49 | 0.55 | -60.0
CAN Renesas RL78 Controller
S.no | level (Spec in Volt) | Diesel | Water | Diff (Milli Volt)
1 | Full (4.9V-5.1) | 5.03 | 5.04 | -10.0
2 | 3/4th(3.75-3.95) | 3.94 | 4.14 | -200.0
3 | Half(2.65-2.85) | 2.71 | 2.88 | -170.0
4 | 1/4th(1.54-1.74) | 1.62 | 1.72 | -100.0
5 | Empty High(0.97-1.17) | 0.98 | 1.09 | -110.0
6 | Empty Low(0.40-0.60) | 0.5 | 0.53 | -30.0
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
