Pranav221294/New_AFT_my_code/AFT_SENSOR/Design_DevelopmentDocs/AFT_Observations/SelfComp/IP+Diesel/self compensation IP + Diesel.xlsx

Sheet: IP + Diesel
Self Compensation of AFT (365 ltrs) |  |  |  |  | Dielectric Constant ( IP + Diesel ) | 2.8
Existing AFT
S.no | level (Spec in Volt) | Diesel | (IP + Diesel) | Diff (Milli Volt)
1 | Full (4.9V-5.1) | 4.97 | 4.97 | 0.0
2 | 3/4th(3.75-3.95) | 3.94 | 3.94 | 0.0
3 | Half(2.65-2.85) | 2.78 | 2.74 | 40.0
4 | 1/4th(1.54-1.74) | 1.68 | 1.64 | 40.0
5 | Empty High(0.97-1.17) | 1.07 | 1.06 | 10.0
6 | Empty Low(0.40-0.60) | 0.52 | 0.51 | 10.0
CAN Renesas RL78 Controller
S.no | level (Spec in Volt) | Diesel | (IP + Diesel) | Diff (Milli Volt)
1 | Full (4.9V-5.1) | 5.04 | 5.04 | 0.0
2 | 3/4th(3.75-3.95) | 3.94 | 4.09 | -150.0
3 | Half(2.65-2.85) | 2.7 | 2.9 | -200.0
4 | 1/4th(1.54-1.74) | 1.64 | 1.83 | -190.0
5 | Empty High(0.97-1.17) | 1.04 | 1.32 | -280.0
6 | Empty Low(0.40-0.60) | 0.5 | 0.52 | -20.0
Snap Shot of Drawing
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
