Pranav221294/New_AFT_my_code/AFT_SENSOR/Design_DevelopmentDocs/AFT_Param_Calculator.xlsx

Stored Parameter |  |  |  |  |  |  | DeskFullWater | on desiel
S.N | Parameter | Value |  |  |  |  |  | Value | 3_4 | 1_2 | 1_4 | EH | 1_2
1 | storedParam_struct.p0_stored | 178857612 | 887 | 687 | 9583 | 15590 | 10085 | 9585 | 9333 | 9333 | 9333 | 9333 | 10094 | 887 | 9337 | 10076
2 | storedParam_struct.p1E_stored | 204280704 | 14175 | 10520 | 11226 | 17011 | 20693 | 10941 | 14673 | 14673 | 14673 | 14673 | 15287 | 14175 | 14673 | 15197
3 | storedParam_struct.p2E_stored | 207659250 | 14246 | 11672 | 11615 | 17144 | 18926 | 11128 | 15696 | 15696 | 15696 | 15696 | 16298 | 14246 | 15696 | 16215
4 | storedParam_struct.p1F_stored | 207976572 | 16945 | 13192 | 11472 | 17309 | 26771 | 11145 | 17259 | 17259 | 17259 | 17259 | 17855 | 16945 | 17259 | 17916
5 | storedParam_struct.p2F_stored | 211579110 | 17406 | 13776 | 11926 | 17463 | 21719 | 11341 | 17983 | 17983 | 17983 | 17983 | 18672 | 17406 | 17983 | 18737
 | caliPara_struct.raw_p1_span | 3695868 | 2770 | 2672 | 246 | 298 | 6078 | 204 | 2586 | 2586 | 2586 | 2586 | 2568 | 2770 | 2586 | 2719
 | caliPara_struct.raw_p2_span | 3919860 | 3160 | 2104 | 311 | 319 | 2793 | 213 | 2287 | 2287 | 2287 | 2287 | 2374 | 3160 | 2287 | 2522
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
