Pranav221294/New_AFT_my_code/AFT_SENSOR/Design_DevelopmentDocs/TDR PWM Value Set in Code.ods

Sheet: Sheet1
Note:TDR25 Value to set for PWM
 | MAX_VAL | Mili volt | MaxOUT | TDR 25
 | 565 | 500 | 5000 | 56.5
 |  | 600 |  | 67.8
 |  | 700 |  | 79.1
 |  | 800 |  | 90.4
 |  | 900 |  | 101.7
 |  | 1000 |  | 113
 |  | 1100 |  | 124.3
 |  | 1200 |  | 135.6
 |  | 1300 |  | 146.9
 |  | 1400 |  | 158.2
 |  | 1500 |  | 169.5
 |  | 1600 |  | 180.8
 |  | 1700 |  | 192.1
 |  | 1800 |  | 203.4
 |  | 1900 |  | 214.7
 |  | 2000 |  | 226
 |  | 2100 |  | 237.3
 |  | 2200 |  | 248.6
 |  | 2300 |  | 259.9
 |  | 2400 |  | 271.2
 |  | 2500 |  | 282.5
 |  | 2600 |  | 293.8
 |  | 2700 |  | 305.1
 |  | 2800 |  | 316.4
 |  | 2900 |  | 327.7
 |  | 3000 |  | 339
 |  | 3100 |  | 350.3
 |  | 3200 |  | 361.6
 |  | 3300 |  | 372.9
 |  | 3400 |  | 384.2
 |  | 3500 |  | 395.5
 |  | 3600 |  | 406.8
 |  | 3700 |  | 418.1
 |  | 3800 |  | 429.4
 |  | 3900 |  | 440.7
 |  | 4000 |  | 452
 |  | 4100 |  | 463.3
 |  | 4200 |  | 474.6
 |  | 4300 |  | 485.9
 |  | 4400 |  | 497.2
 |  | 4500 |  | 508.5
 |  | 4600 |  | 519.8
 |  | 4700 |  | 531.1
 |  | 4800 |  | 542.4
 |  | 4900 |  | 553.7
 |  | 5000 |  | 565
 |  | 5100 |  | 576.3
 |  | 5200 |  | 587.6
 |  | 5300 |  | 598.9
 |  | 5400 |  | 610.2
 |  | 5500 |  | 621.5
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
