Pranav221294/New_AFT_my_code/AFT_SENSOR/Design_DevelopmentDocs/CanHexToDec/CanHexToDec.xlsx

S.N | P0 | P1 | P2
1
2
3
4
5
6
7
