Pranav221294/New_AFT_my_code/AFT_SENSOR/Design_DevelopmentDocs/AFT_Observations/TetsOnOldPcbAtDesiel/data_excel/TimePeriodFreq_p1_p2_p0.ods

S.N. | P1 ON Time (ms) | P1 Freq | P1 duty(%) | 555 freq (P1 ON), duty | P2 ON Time | P2 Freq | P2 duty | 555 freq (P2 ON), duty | Fluid Level Position | p0 Freq’ | P1 counts Live | P2 counts Live | Calc P1 | Calc P2
1 | 72.8 | 2.436 Hz | 17.75 | 34.247, 67.12 | 58.3 | 2.436 | 14.2 | 35.842, 67.03 | Full | 63.69 | 17857 | 18673 | 2570 | 2375 | 195
2 | 72.8 | 2.436 Hz | 17.76 | 34.247, 67.12 | 58.3 | 2.436 | 14.2 | 35.842, 67.03 | Below Full |  | 17541 | 18379 | 2254 | 2081 | 173
3 | 71.22 | 2.438 | 17.36 | 35.211 | 57.28 | 2.433 | 13.94 | 37.037 | Above ¾ |  |  |  |  |  | 0
4 | 71 | 2.404 | 17.08 | 35.336, 67.14 | 59.6 | 2.404 | 14.34 | 37.175, 67.04 | ¾ | 63.69 | 17245 | 18106 | 1958 | 1808 | 150
5 | 70.99 | 2.397 | 17.02 | 35.46 | 60.18 | 2.397 | 14.43 | 37.175, 67.04 | Below ¾ |  | 16932 | 17814 | 1645 | 1516 | 129
6 | 69.34 | 2.402 | 16.66 | 36.49 | 58.8 | 2.402 | 14.77 | 38.46 | Above ½ |  |  |  |  |  | 0
7 | 69 | 2.432 | 16.8 | 36.63 , 67.03 | 62.68 | 2.432 | 15.25 | 38.61, 67.18 | ½ | 63.63 | 16582 | 17489 | 1295 | 1191 | 104
8 | 67.1 | 2.38 | 15.98 | 37.87 | 52.7 | 2.381 | 12.55 | 40.161 | ¼ | 63.69 |  |  |  |  | 0
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
