Pranav221294/New_AFT_my_code/AFT_SENSOR/Design_DevelopmentDocs/AFT_Observations/TetsOnOldPcbAtDesiel/data_excel/Untitled 1.xlsx

Stored Parameter |  |  |  |  |  |  | DeskFullWater | on desiel
S.N | Parameter | Value | desiel full | d. over |  |  |  | Value |  | FACTOR
1 | storedParam_struct.p0_stored | 9361 | 10094 | 10095 | 9361 | 9361 | 9361 | 9361 | 9407.805 | 1.005
2 | storedParam_struct.p1E_stored | 14586 | 15287 | 15288 | 14586 | 14586 | 14586 | 14586 | 14658.93
3 | storedParam_struct.p2E_stored | 15671 | 16298 | 16299 | 15671 | 15671 | 15671 | 15671 | 15749.355
4 | storedParam_struct.p1F_stored | 17229 | 17855 | 17856 | 17229 | 17229 | 17229 | 17229 | 17229
5 | storedParam_struct.p2F_stored | 18128 | 18672 | 18673 | 18128 | 18128 | 18128 | 18128 | 18128
 | caliPara_struct.raw_p1_span | 2643 | 2568 | 2568 | 2643 | 2643 | 2643 | 2643 | 2570.07
 | caliPara_struct.raw_p2_span | 2457 | 2374 | 2374 | 2457 | 2457 | 2457 | 2457 | 2378.645
6 | storedParam_struct.m_stored | 6.794786325 | 6.752249368 | 6.752249368 | 6.794786325 | 6.794786325 | 6.794786325 | 6.794786325 | 6.761031217
7 | storedParam_struct.div_stored | 1.009165754 | 1.004033857 | 1.004033857 | 1.009165754 | 1.009165754 | 1.009165754 | 1.009165754 | 1.005135277
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
