Pranav221294/New_AFT_my_code/AFT_SENSOR/Design_DevelopmentDocs/Diesel_Data_on_2_probe_Pic.png

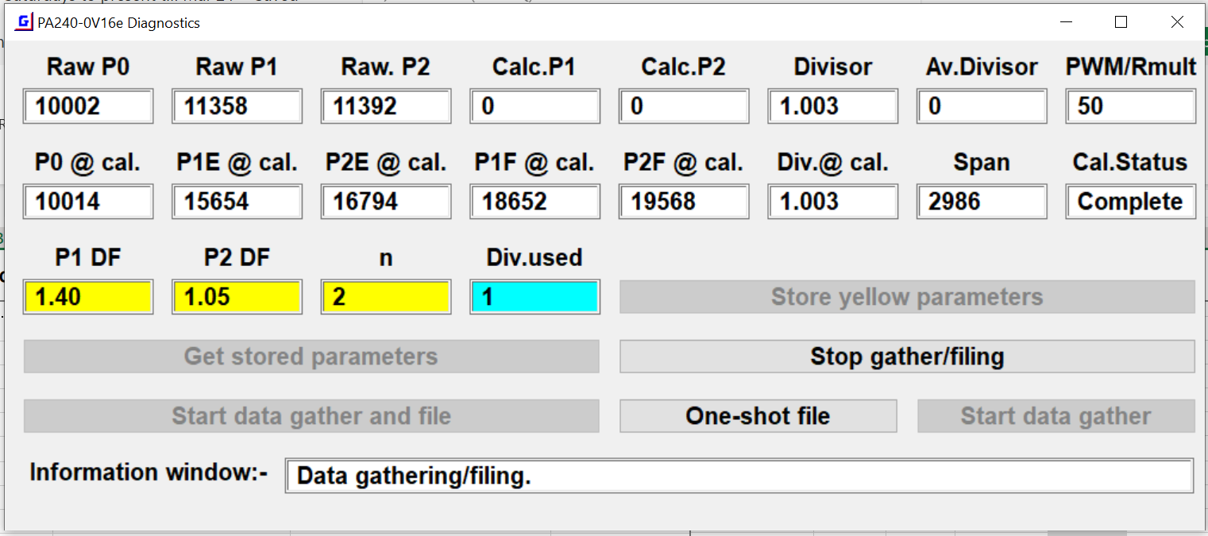
AFT_SENSOR/Design_DevelopmentDocs/Diesel_Data_on_2_probe_Pic.png
