Pranav221294/New_AFT_my_code/AFT_SENSOR/Design_DevelopmentDocs/AFT_GUI/AFT_GUI_CALIBRATION_PROTOCOL.xlsx

To connect with sensor
Request
ID | D1 | D2 | D3 | D4 | D5 | D6 | D7 | D8
18FF6425 (Send by GUI) (1 sec Interval) | xx | xx | xx | xx | xx | xx | xx | xx | Table 1
 |  |  |  |  |  |  |  |  | Value (decimal) | Message
 |  |  |  |  |  |  |  |  | 4 | Empty calibration in process
Response |  |  |  |  |  |  |  |  | 2 | Empty calibration Success
ID | D1 | D2 | D3 | D4 | D5 | D6 | D7 | D8 | 8 | Full calibration in process
18FF5625 (Send by Sensor) | xx | xx | xx | xx | xx | xx | xx | xx | 6 | Full calibration Success
 |  |  |  |  |  |  |  |  | Table 2
To Start Calibration at Empty Level |  |  |  |  |  |  |  |  | Value (decimal) | Message
 |  |  |  |  |  |  |  |  | 1 | Calibration Doing Correctly
Request |  |  |  |  |  |  |  |  | 2 | Calibration Not Doing Correctly
ID | D1 | D2 | D3 | D4 | D5 | D6 | D7 | D8 | 3 | Minimum Level of Fuel Required
18FF6525 (Send by GUI) (On Click) | xx | xx | xx | xx | xx | xx | xx | xx | 4 | Minimum Level of Fuel Achieved
Response
ID | D1 | D2 | D3 | D4 | D5 | D6 | D7 | D8
18FF5725 (Send by Sensor) | FF | FF | xx | xx | xx | xx | xx | xx
 | Time in Seconds | Ref Table 1
To Start Calibration at Full Level
Request
ID | D1 | D2 | D3 | D4 | D5 | D6 | D7 | D8
18FF6625 (Send by GUI) (On Click) | xx | xx | xx | xx | xx | xx | xx | xx
Response
ID | D1 | D2 | D3 | D4 | D5 | D6 | D7 | D8
18FF5725 (Send by Sensor) | FF | xx | xx | xx | xx | xx | xx | xx
 | Time in Seconds | Ref Table 1
To disconnect from sensor
Request
ID | D1 | D2 | D3 | D4 | D5 | D6 | D7 | D8
18FF6825 (Send by GUI) (On Click) | xx | xx | xx | xx | xx | xx | xx | xx
Response
ID | D1 | D2 | D3 | D4 | D5 | D6 | D7 | D8
18FF5925 (Send by Sensor) | xx | xx | xx | xx | xx | xx | xx | xx
Level Monitoring status after empty calibration success
Request
ID | D1 | D2 | D3 | D4 | D5 | D6 | D7 | D8
18FF6625 (Send by GUI) (On Click) | xx | xx | xx | xx | xx | xx | xx | xx
Response
ID | D1 | D2 | D3 | D4 | D5 | D6 | D7 | D8
18FF5725 (Send by Sensor) | FF | xx | xx | xx | xx | xx | xx | xx
 |  |  | Ref Table 2
