Pranav221294/New_AFT_my_code/AFT_SENSOR/Design_DevelopmentDocs/Disesl 555 timer/water and disesl 555 timer frequency in 600mm.ods

Sheet: Sheet1
Disesl 600 mm | P1 frequency(Khz) | P2 frequency(Khz) | P0 frequency(P0)
Full | 35.461 | 36.765 | 66.66
3_4 | 36.496 | 37.879
1_2 | 37.879 | 39.37
1_4 | 39.37 | 40.984
E(H) | 40 | 42.017
E(L) | 40.65 | 43.103
Existing Pcb in Microchip
Count for 1 | 8 | pulse | Total Pulses | 255
 |  |  |  |  | For 8 pulse = 1 count |  |  | Total time for 255 |  |  | Total Time(ms)
Disesl 600 mm | P1 frequency(us) | P2 frequency(us) | P0 time(us) |  | P1 time(us) | P2 time(us) | P0 time(P0) | In (ms)
Full | 28.199 | 27.199 | 15.15 |  | 225.592 | 217.592 | 121.2 | 57.52596 | 55.48596 | 30.906 | 143.91792
3_4 | 27.4 | 27.115 |  |  | 219.2 | 216.92 |  | 55.896 | 55.3146 | 30.906 | 142.1166
1_2 | 26.399 | 25.4 |  |  | 211.192 | 203.2 |  | 53.85396 | 51.816 | 30.906 | 136.57596
1_4 | 25.4 | 24.399 |  |  | 203.2 | 195.192 |  | 51.816 | 49.77396 | 30.906 | 132.49596
E(H) | 25 | 23.799 |  |  | 200 | 190.392 |  | 51 | 48.54996 | 30.906 | 130.45596
E(L) | 24.6 | 23.2002 |  |  | 196.8 | 185.6016 |  | 50.184 | 47.328408 | 30.906 | 128.418408
New Pcb in Renesas
Count for 1 pulse | 32 | pulse | Total Pulses | 255
 |  |  |  |  | For 32 pulse = 1 count |  |  | Total time for 255 |  |  | Total Time(ms)
Disesl 600 mm | P1 frequency(us) | P2 frequency(us) | P0 time(us) |  | P1 time(us) | P2 time(us) | P0 time(P0) | In (ms)
Full | 28.199 | 27.199 | 15.15 |  | 902.368 | 870.368 | 484.8 | 230.10384 | 221.94384 | 123.624 | 575.67168
3_4 | 27.4 | 27.115 |  |  | 876.8 | 867.68 |  | 223.584 | 221.2584 | 123.624 | 568.4664
1_2 | 26.399 | 25.4 |  |  | 844.768 | 812.8 |  | 215.41584 | 207.264 | 123.624 | 546.30384
1_4 | 25.4 | 24.399 |  |  | 812.8 | 780.768 |  | 207.264 | 199.09584 | 123.624 | 529.98384
E(H) | 25 | 23.799 |  |  | 800 | 761.568 |  | 204 | 194.19984 | 123.624 | 521.82384
E(L) | 24.6 | 23.2002 |  |  | 787.2 | 742.4064 |  | 200.736 | 189.313632 | 123.624 | 513.673632

Sheet: Sheet2
Water 600 mm | P1 frequency(Khz) | P2 frequency(Khz) | P0 frequency(Khz)
Full | 25.51 | 19.084 | 66.66
3_4 | 28.249 | 22.321
1_2 | 31.447 | 26.596
1_4 | 35.461 | 32.468
E(H) | 38.168 | 37.037
E(L) | 40.65 | 42.735
Constant1 | 1000000
Constant2 | 1000
Existing Pcb in Microchip
Count for 1 | 8 | pulse | Total Pulses | 255
 |  |  |  |  | For 8 pulse = 1 count |  |  | Total time for 255 |  |  | Total Time(ms)
Water 600 mm | P1 frequency(us) | P2 frequency(us) | P0 time(us) |  | P1 time(us) | P2 time(us) | P0 time(P0) | In (ms)
Full | 39.2003136025088 | 52.3999161601341 | 15.15 |  | 313.602508820071 | 419.199329281073 | 121.2 | 79.968639749118 | 106.895828966674 | 30.906 | 217.770468715792
3_4 | 35.3994831675458 | 44.8008601765154 |  |  | 283.195865340366 | 358.406881412123 |  | 72.2149456617933 | 91.3937547600914 | 30.906 | 194.514700421885
1_2 | 31.7995357267784 | 37.5996390434652 |  |  | 254.396285814227 | 300.797112347721 |  | 64.8710528826279 | 76.703263648669 | 30.906 | 172.480316531297
1_4 | 28.1999943600011 | 30.7995564863866 |  |  | 225.599954880009 | 246.396451891093 |  | 57.5279884944023 | 62.8310952322286 | 30.906 | 151.265083726631
E(H) | 26.1999580800671 | 27.000027000027 |  |  | 209.599664640537 | 216.000216000216 |  | 53.4479144833368 | 55.0800550800551 | 30.906 | 139.433969563392
E(L) | 24.60024600246 | 23.4000234000234 |  |  | 196.80196801968 | 187.200187200187 |  | 50.1845018450185 | 47.7360477360477 | 30.906 | 128.826549581066
Existing Pcb in Microchip
Count for 1 | 32 | pulse | Total Pulses | 255
 |  |  |  |  | For 8 pulse = 1 count |  |  | Total time for 255 |  |  | Total Time(ms)
Water 600 mm | P1 frequency(us) | P2 frequency(us) | P0 time(us) |  | P1 time(us) | P2 time(us) | P0 time(P0) | In (ms)
Full | 39.2003136025088 | 52.3999161601341 | 15.15 |  | 1254.41003528028 | 1676.79731712429 | 121.2 | 319.874558996472 | 427.583315866695 | 30.906 | 778.363874863167
3_4 | 35.3994831675458 | 44.8008601765154 |  |  | 1132.78346136146 | 1433.62752564849 |  | 288.859782647173 | 365.575019040366 | 30.906 | 685.340801687539
1_2 | 31.7995357267784 | 37.5996390434652 |  |  | 1017.58514325691 | 1203.18844939089 |  | 259.484211530512 | 306.813054594676 | 30.906 | 597.203266125188
1_4 | 28.1999943600011 | 30.7995564863866 |  |  | 902.399819520036 | 985.585807564371 |  | 230.111953977609 | 251.324380928915 | 30.906 | 512.342334906524
E(H) | 26.1999580800671 | 27.000027000027 |  |  | 838.398658562146 | 864.000864000864 |  | 213.791657933347 | 220.32022032022 | 30.906 | 465.017878253568
E(L) | 24.60024600246 | 23.4000234000234 |  |  | 787.207872078721 | 748.800748800749 |  | 200.738007380074 | 190.944190944191 | 30.906 | 422.588198324265
