Pranav221294/New_AFT_my_code/AFT_SENSOR/Design_DevelopmentDocs/AFT_Observations/TestOnZylene/29-12-2022/Test 1.ods

Tested On 225L variant in plastic jar
Existing Software
S.N | Level On Jar (mL) | V.Out of Fozmula SW with diesel (Volt) | V.Out of Fozmula SW with Zylene (Volt) | Voltage Difference (Volt)
1 | 400 | 0.933 | 0.992 | 0.059
2 | 800 | 1.911 | 2.043 | 0.132
3 | 1200 | 2.879 | 3.182 | 0.303
4 | 1500 | 3.447 | 3.945 | 0.498
5 | 1800 | 4.267 | 4.708 | 0.441
New Software
S.N | Level On Jar (mL) | V.Out of New SW with diesel (Volt) | V.Out of New SW with Zylene (Volt) | Voltage Difference (Volt)
1 | 400 | 0.956 | 1.043 | 0.087
2 | 800 | 1.875 | 1.962 | 0.087
3 | 1200 | 2.795 | 2.857 | 0.062
4 | 1500 | 3.478 | 3.54 | 0.062
5 | 1800 | 3.975 | 4.211 | 0.236
