Pranav221294/New_AFT_my_code/AFT_SENSOR/Design_DevelopmentDocs/AFT_Observations/No calibration .png

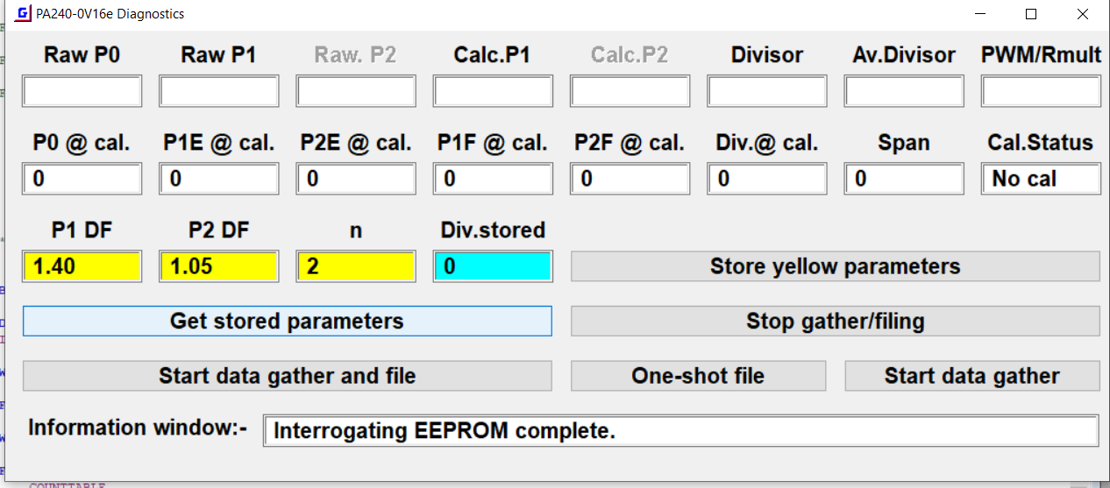
AFT_SENSOR/Design_DevelopmentDocs/AFT_Observations/No calibration .png
