Pranav221294/New_AFT_my_code/AFT_SENSOR/Design_DevelopmentDocs/AFT_Observations/TestOnZylene/10-01-2023/test on diesel/at level 1400 of plastic jar existing reading 2.978v.png

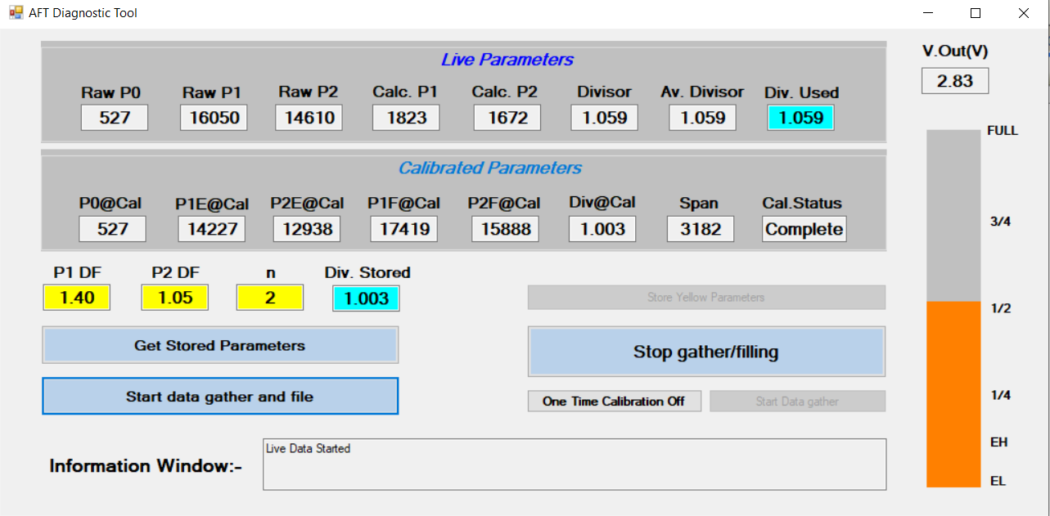
AFT_SENSOR/Design_DevelopmentDocs/AFT_Observations/TestOnZylene/10-01-2023/test on diesel/at level 1400 of plastic jar existing reading 2.978v.png
