Pranav221294/New_AFT_my_code/AFT_SENSOR/Design_DevelopmentDocs/Calibartion and Live values in new pcb/Calibration.PNG

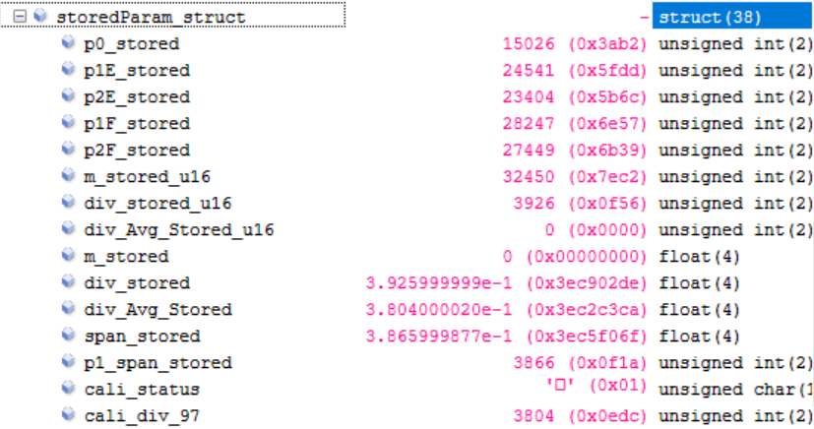
AFT_SENSOR/Design_DevelopmentDocs/Calibartion and Live values in new pcb/Calibration.PNG
