Pranav221294/New_AFT_my_code/AFT_SENSOR/PCB&Schematics/26042022114515_PCB40.001R5 SCHEMATIC (2).pdf

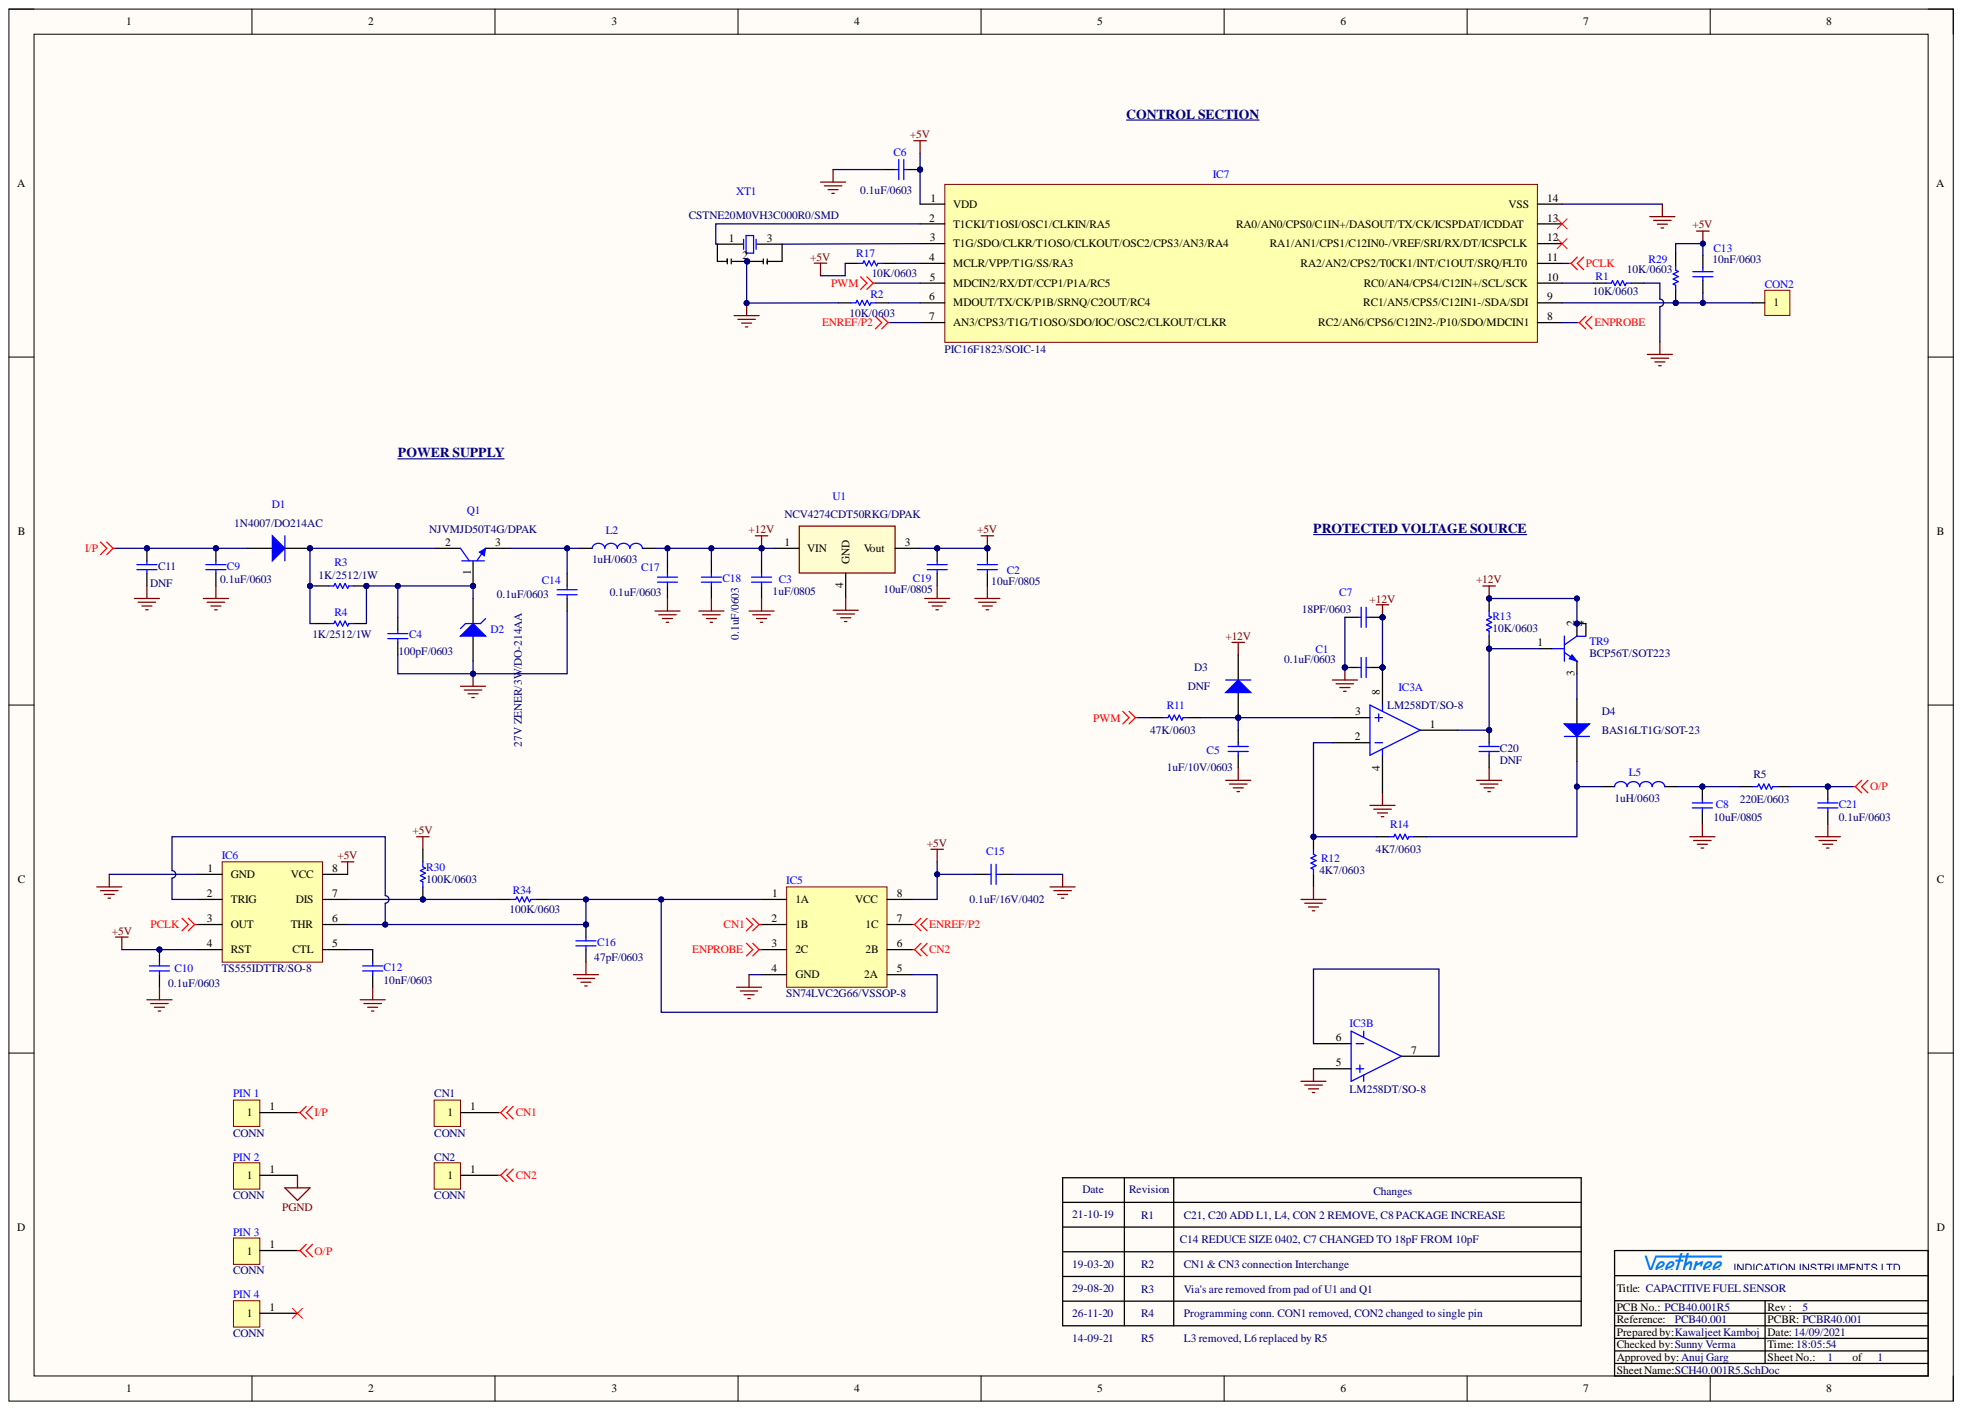
[picture p39: page 1]

T1G/SDO/CLKR/T1OSO/CLKOUT/OSC2/CPS3/AN3/RA4 3

2 | +5V | MCLR/VPP/T1G/SS/RA3 4

MDCIN2/RX/DT/CCP1/P1A/RC5 5
MDOUT/TX/CK/P1B/SRNQ/C2OUT/RC4 6

Date | Revision | Changes

21-10-19 | R1 | C21, C20 ADD L1, L4, CON 2 REMOVE, C8 PACKAGE INCREASE

C14 REDUCE SIZE 0402, C7 CHANGED TO 18pF FROM 10pF

19-03-20 | R2 | CN1 & CN3 connection Interchange

Title: CAPACITIVE FUEL SENSOR
PCB No.: PCB40.001R5

Reference: PCB40.001 | PCBR: PCBR40.001
Prepared by: Kawaljeet Kamboj | Date: 14/09/2021
Checked by:Sunny Verma | Time: 18:05:54
Approved by: Anuj Garg | Sheet No.: 1 of 1
