Pranav221294/New_AFT_my_code/AFT_SENSOR/PCB&Schematics/SCH40.001R7 SCHEMATIC.pdf

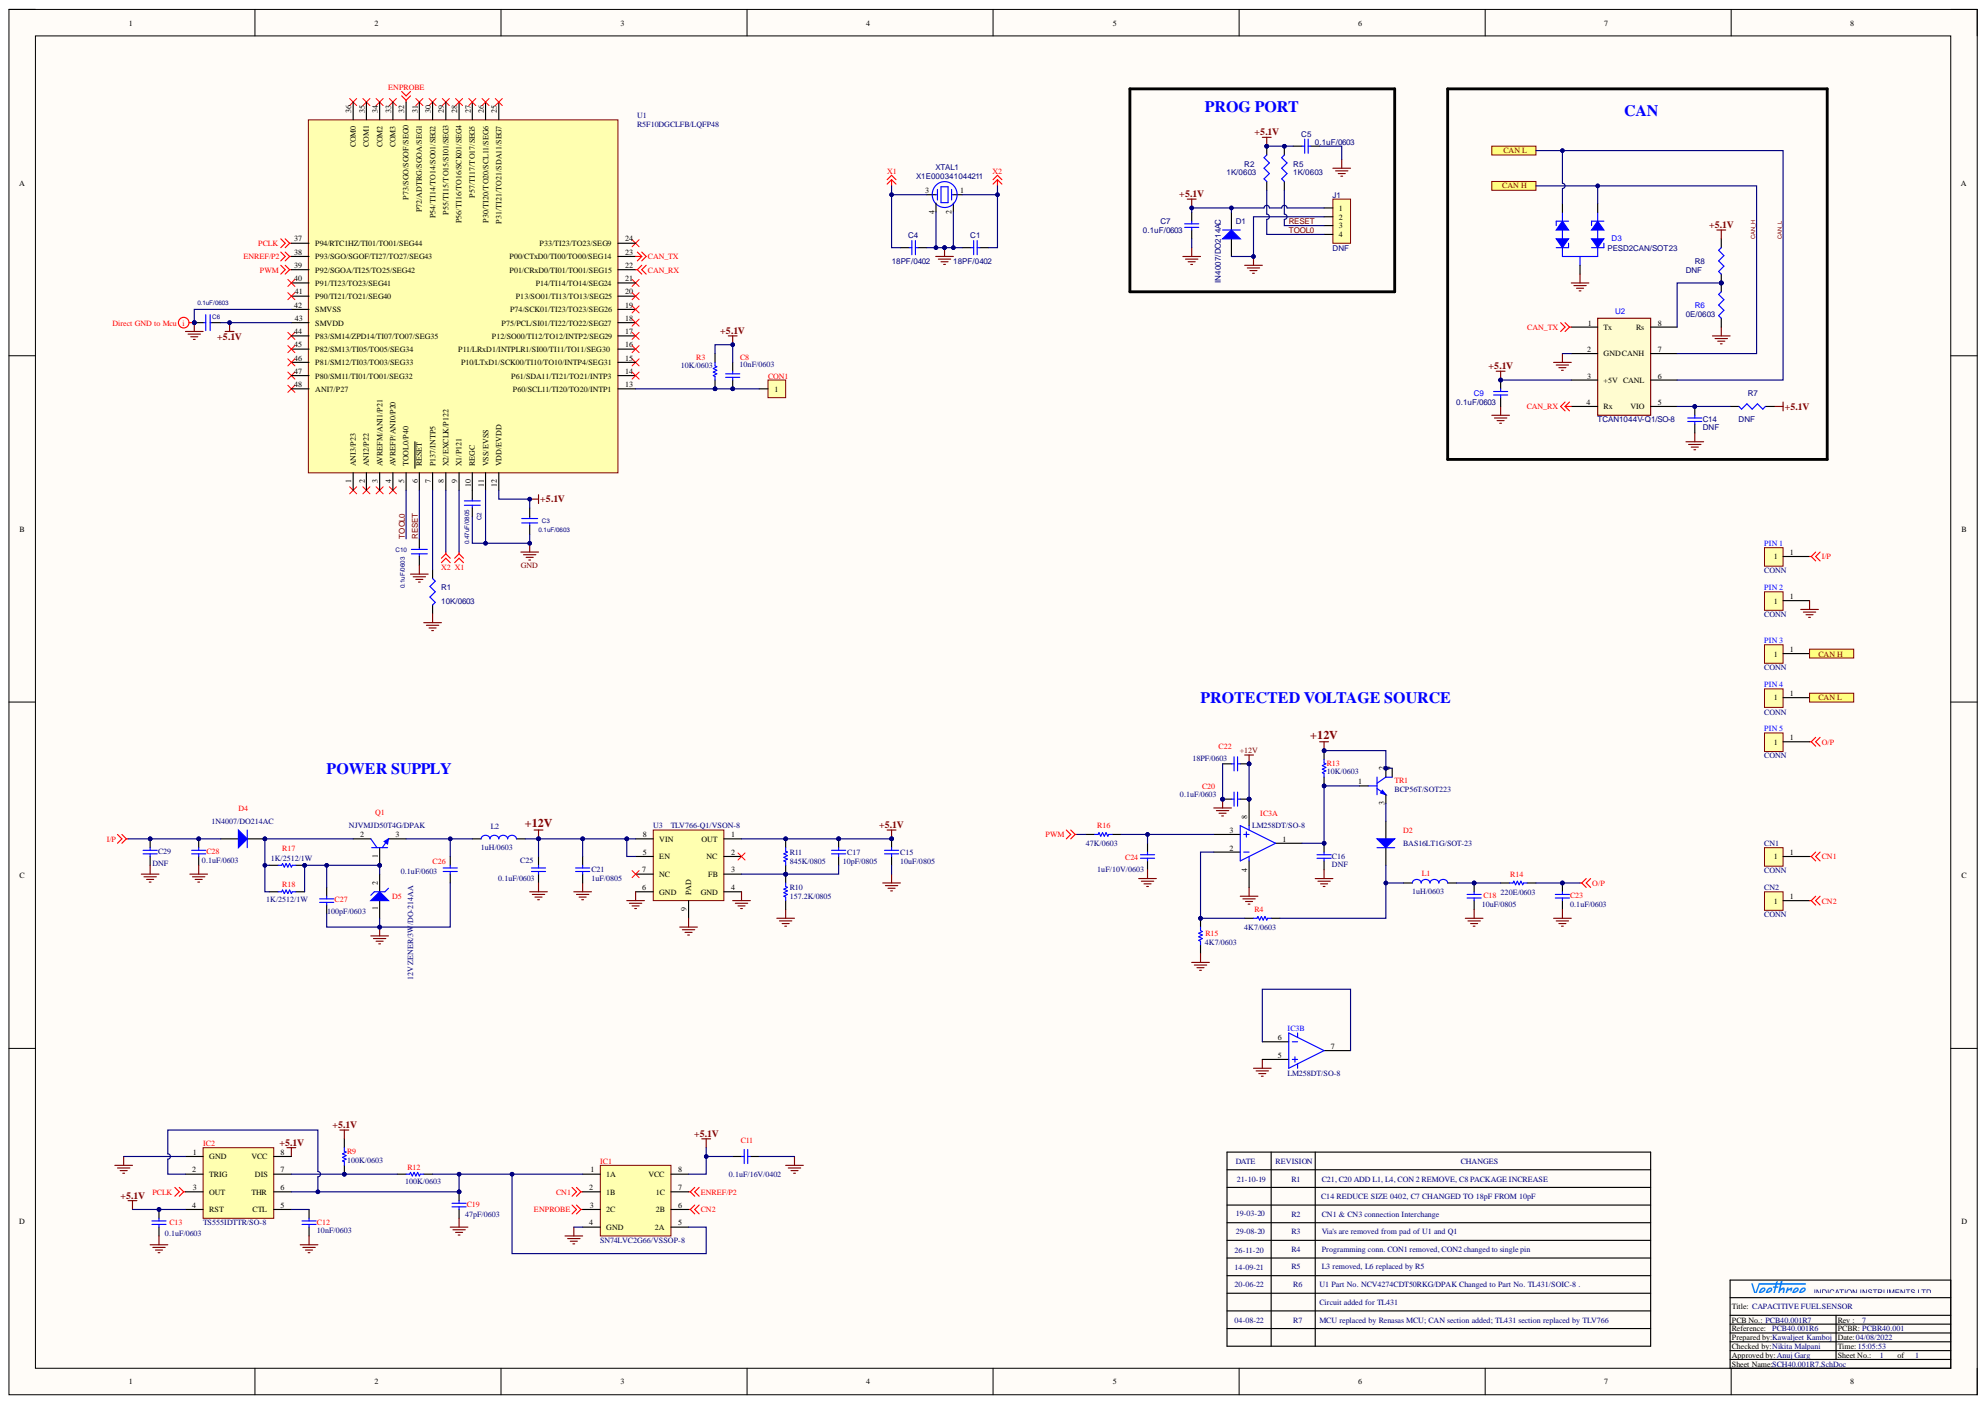
[picture p40: page 1]

D1 | RESET

Direct GND to Mcu i

C14 REDUCE SIZE 0402, C7 CHANGED TO 18pF FROM 10pF

14-09-21 | R5 | L3 removed, L6 replaced by R5

20-06-22 | R6 | U1 Part No. NCV4274CDT50RKG/DPAK Changed to Part No. TL431/SOIC-8 .

Reference: PCB40.001R6 | PCBR: PCBR40.001
Prepared by: Kawaljeet Kamboj | Date: 04/08/2022
Checked by:Nikita Malpani | Time: 15:05:53
Approved by:Anuj Garg | Sheet No.: 1 of 1
