Pranav221294/New_AFT_my_code/AFT_SENSOR/PCB&Schematics/PCB40.001R7 ASSEMBLY DRAWING (1).pdf

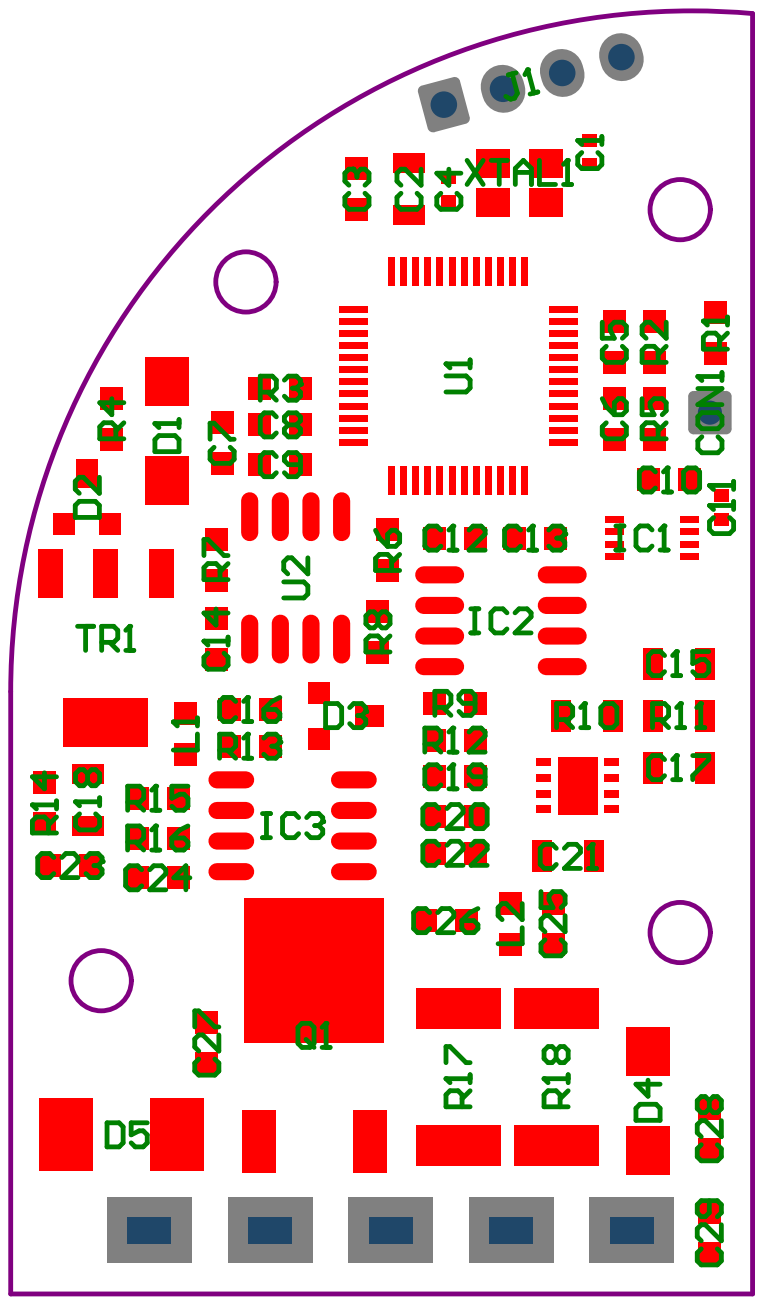
[picture p41: page 1]

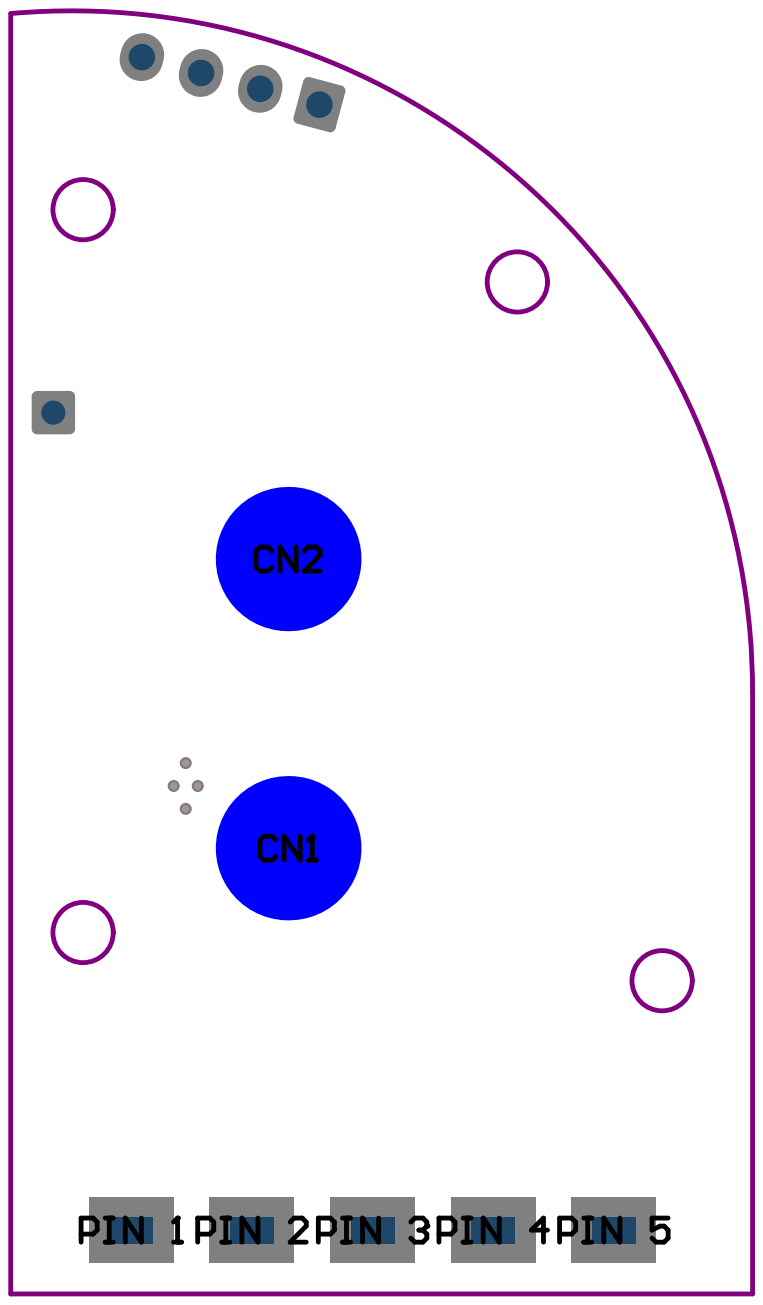
[picture p42: page 2]
