Pranav221294/New_AFT_my_code/AFT_SENSOR/Code/AFT_Sensor_Code/UserFiles/CurveHeader.h

/** ###################################################################
**     Filename  : CurveHeader.h
**     Project   : Y1ClusterDiagnostics
**     Processor : MC9S12XHZ256VAG
**     Compiler  : CodeWarrior HCS12X C Compiler
**     Date/Time : 25/01/2018, 14:28
**     Contents  :
**         User source code
**
** ###################################################################*/

#ifndef __CurveHeader_H
#define __CurveHeader_H


#include "CustomDataTypes.h"
#include "User.h"
/* MODULE CurveHeader */


// public interface ---------------------------------------------------------


typedef enum
{

	eFuelLevelToVoltage,
    eNumofCurveTypes
} eCurveType;


void vGetCurveDataValue(eCurveType, u32, u32 *);
 
/* END CurveHeader */

#endif
