Pranav221294/New_AFT_my_code/AFT_SENSOR/Code/AFT_Sensor_Code/UserFiles/CustomDataTypes.h

#ifndef __CustomDataTypes__
#define __CustomDataTypes__

#include "r_cg_macrodriver.h"


typedef unsigned char 	u8;
typedef signed char 	s8;
typedef unsigned int 	u16;
typedef signed int 		s16;
typedef unsigned long 	u32;
typedef signed long 	s32;
typedef unsigned char 	bool;

#define TRUE	1
#define HIGH	1
#define SET		1
#define ON		1
#define true	1

#define FALSE	0
#define LOW		0
#define RESET	0
#define OFF		0
#define false	0



#endif
