Pranav221294/New_AFT_my_code/AFT_SENSOR/Code/AFT_Sensor_Code/UserFiles/CalibrationByCAN.h

/****************************************************************************************************************/
/* COPYRIGHT                                                                                                    */
/* Inidication Instruments Ltd.(c) 2022                                                                         */
/****************************************************************************************************************/
/* File name   : {file_name}                                                                                    */
/* Module      : {file_path}                                                                                    */
/*--------------------------------------------------------------------------------------------------------------*/
/* Description :                                                                                                */
/****************************************************************************************************************/
/* History                                                                                                      */
/*--------------------------------------------------------------------------------------------------------------*/
/* Date       | Revised By  | Rev. No.  | Description                                                           */
/*--------------------------------------------------------------------------------------------------------------*/
/*                                                                                                              */
/****************************************************************************************************************/

#ifndef __CALIBRATIONBYCAN_H__
#define __CALIBRATIONBYCAN_H__

/****************************************************************************************************************/
/* File Includes                                                                                                */
/****************************************************************************************************************/

#include "r_cg_macrodriver.h"
#include "CustomDataTypes.h"
#include "User.h"
#include "GuiCommProtocol.h"
#include "Calibration.h"
#include "Can.h"
#include "r_cg_wdt.h"
#include "levelCalc.h"
#include "DiagnosticData.h"
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
